jcook-200/Piano2Bluetooth/README.md

# Piano2Bluetooth
A hardware and software project to let a digital piano connect to Bluetooth headphones.

## Scructure
