jcook-200/Piano2Bluetooth/Hardware/Bluetooth2Audio_BOM.ods

Reference | Qty | Value | Footprint | Order Quantity | Datasheet
C1,C2,C3,C4,C24,C29,C30,C44,C45,C46,C49,C50,C62 | 13 | 1uF | 0603 | 20 | https://www.mouser.ca/ProductDetail/TAIYO-YUDEN/TMK107B7105KA-T?qs=PzICbMaShUfoHRKdwm1IMg%3D%3D
C5,C6,C7,C8,C9,C10,C13,C14,C18,C21,C22,C23,C25,C26,C27,C28,C36,C37,C39,C40,C41,C42,C43,C52,C54,C58 | 26 | 0.1uF | 0402 | 30 | https://www.mouser.ca/ProductDetail/Murata-Electronics/GRM155R71H104KE14D?qs=2UZY3JfgLCy9gG9icKV9Yg%3D%3D
C11,C12 | 2 | 6pF | 0402 | 10 | https://www.mouser.ca/ProductDetail/Murata-Electronics/GCM1555C1H6R0FA16D?qs=QzBtWTOodeWzC0V5O%2FcGPw%3D%3D
C15,C19 | 2 | 1uF | 0402 | 10 | https://www.mouser.ca/ProductDetail/KYOCERA-AVX/KAM05CR71A105KH?qs=mELouGlnn3cmaPoDXE8tAg%3D%3D
C16,C20 | 2 | 0.47uF | 0402 | 10 | https://www.mouser.ca/ProductDetail/TAIYO-YUDEN/LMK105B7474KV-F?qs=vF%252B8ahGVileYO6xOnPUEWw%3D%3D
C17 | 1 | 22pF | 0402 | 10 | https://www.mouser.ca/ProductDetail/Murata-Electronics/GCM1555C1H220FA16J?qs=QzBtWTOodeUtHGKP08uOlA%3D%3D
C31,C32 | 2 | 10pF | 0402 | 10 | https://www.mouser.ca/ProductDetail/Murata-Electronics/GCM1555C1H100FA16D?qs=QzBtWTOodeXF6kFfVGmBsg%3D%3D
C33,C34 | 2 | 12pF | 0402 | 10 | https://www.mouser.ca/ProductDetail/Murata-Electronics/GRT1555C1H120FA02D?qs=RcG8xmE7yp0kAtgCCwJUqg%3D%3D
Extra | 2 | 6.8pF | 0402 | 10 | https://www.mouser.ca/ProductDetail/Murata-Electronics/GCM1555C1H6R8FA16D?qs=QzBtWTOodeXhT%2FHc0qePDg%3D%3D
Extra | 2 | 8.2pF | 0402 | 10 | https://www.mouser.ca/ProductDetail/Murata-Electronics/GRM1555C1H8R2BA01D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
Extra | 2 | 15pF | 0402 | 10 | https://www.mouser.ca/ProductDetail/Murata-Electronics/GRM1555C1H150GA01D?qs=ouTquLLW2S77kt6sL0jekQ%3D%3D
Extra | 2 | 18pF | 0402 | 10 | https://www.mouser.ca/ProductDetail/Murata-Electronics/GRM1555C1H180GA01J?qs=ouTquLLW2S426X7sE1YQ3Q%3D%3D
Extra | 2 | 4.7pF | 0402 | 10 | https://www.mouser.ca/ProductDetail/Murata-Electronics/GRM1555C1H4R7BA01D?qs=ouTquLLW2S7tatpo%2F6wZ1w%3D%3D
C35,C47,C48,C57,C63 | 5 | 10uF | 0805 | 10 | https://www.mouser.ca/ProductDetail/Murata-Electronics/GRM21BZ71E106KE15L?qs=Ey7%2FXF42M3fdXe9bIpCO9w%3D%3D
C38 | 1 | 4.7uF | 0603 | 10 | https://www.mouser.ca/ProductDetail/Murata-Electronics/GRM188Z71C475KE21D?qs=d0WKAl%252BL4KajNOvalhHKtQ%3D%3D
C51,C53 | 2 | 10uF | 1206 | 10 | https://www.mouser.ca/ProductDetail/TAIYO-YUDEN/MSASG31LAB7106KTNB25?qs=tlsG%2FOw5FFiGynen7GjezA%3D%3D
C55,C59 | 2 | 1uF | 5x10mm rectangle | 3 | https://www.mouser.ca/ProductDetail/WIMA/MKS2C041001F00JSSD?qs=ISKKXg98%252B1lQgUuGZjf9mQ%3D%3D
C56,C60 | 2 | 0.01uF | 0603 | 10 | https://www.mouser.ca/ProductDetail/TAIYO-YUDEN/MSASG31LAB7106KTNB25?qs=tlsG%2FOw5FFiGynen7GjezA%3D%3D
C61 | 1 | 0.1uF | 0603 | 10 | https://www.mouser.ca/ProductDetail/YAGEO/CC0603KRX7R9BB104?qs=vTakOoo5QyLvVCYM2ge8LQ%3D%3D
FB1 | 1 | 600R | 0603 | 2 | https://www.mouser.ca/ProductDetail/TAIYO-YUDEN/LCMGA160808T601RG?qs=tlsG%2FOw5FFiusHMHvy1xRQ%3D%3D
FL1 | 1 | LFB212G45SG8C341 | 0805 | 2 | https://www.mouser.ca/ProductDetail/Murata-Electronics/LFB212G45SG8C341?qs=j1g11T5MHkp13%252BQehp0bLA%3D%3D
J1 | 1 | 01x04 Socket | 1x4 2mm | 1 | https://www.mouser.ca/ProductDetail/Samtec/HTSW-104-07-F-S?qs=0lQeLiL1qyZ97IEIrOguNw%3D%3D
J2 | 1 | Debugging STDC14 | PinHeader 02x07mm Pitch 1.27mm | 1 | https://www.mouser.ca/ProductDetail/Samtec/FTSH-107-01-F-D?qs=0lQeLiL1qyaNpP9xc4E0bg%3D%3D
J3 | 1 | 35RAPC4BV4 | 35RAPC4BV4 | 1 | https://www.mouser.ca/ProductDetail/Switchcraft/35RAPC4BV4?qs=yPI4UV3pIw2%252BAY61NTBatA%3D%3D
J4 | 1 | USB_A | USB-A Molex 67643-0901 | 1 | https://www.mouser.ca/ProductDetail/Molex/67643-0910?qs=EuyFtE1skifNhj6pwWTsXw%3D%3D
L1 | 1 | 4.7uH | 0808 | 2 | https://www.mouser.ca/ProductDetail/Coilcraft/EPL2010-472MLC?qs=zCSbvcPd3pbkiwv4%252B5Bupg%3D%3D
R1,R2,R3,R8,R9 | 5 | 10K | 0603 | 10 | https://www.mouser.ca/ProductDetail/YAGEO/AC0603FR-0710KL?qs=UoPT7wUmgYKz3zh0UDMA4Q%3D%3D
R4,R17,R20 | 3 | 100R | 0603 | 10 | https://www.mouser.ca/ProductDetail/YAGEO/RP0603BRD07100RL?qs=Y0Uzf4wQF3kknSv0x4foKw%3D%3D
R5,R6 | 2 | 4K7 | 0603 | 10 | https://www.mouser.ca/ProductDetail/YAGEO/RC0603FR-074K7L?qs=gt6vzsuosg37y0l7Vt36bQ%3D%3D
R7,R10,R11,R12,R13 | 5 | 22R | 0603 | 10 | https://www.mouser.ca/ProductDetail/YAGEO/RC0603JR-0722RL?qs=%2F9ZTgpVJnN5zDbBVzV1%252B0w%3D%3D
R14 | 1 | 150K | 0603 | 10 | https://www.mouser.ca/ProductDetail/YAGEO/AC0603FR-07150KL?qs=yhV1fb9g%2FKbGHv1fnPiGNw%3D%3D
R15 | 1 | 16K | 0603 | 10 | https://www.mouser.ca/ProductDetail/YAGEO/AC0603FR-0716KL?qs=yhV1fb9g%2FKbveWp4BLOPMQ%3D%3D
R16,R18,R19 | 3 | 0R | 0603 | 10 | https://www.mouser.ca/ProductDetail/Vishay/CRCW06030000Z0EA?qs=uFJqmf%2F3rbbVtxvMdbYUaQ%3D%3D
SW1 | 1 | EN12-VS20AF20 | EN12VS20AF20 | 1 | https://www.mouser.ca/ProductDetail/BI-Technologies-TT-Electronics/EN12-VS20AF20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
SW2 | 1 | SW | Button_Switch_SMD:SW_SPDT_PCM12 | 1 | https://www.mouser.ca/ProductDetail/CK/PCM12SMTBR?qs=By6Nw2ByBD1OEOnWcdZb2g%3D%3D
SW3 | 1 | SW_Push | Button_Switch_THT:SW_PUSH_6mm_H5mm | 1 | https://www.mouser.ca/ProductDetail/Same-Sky/TS02-66-50-BK-100-LCR-D?qs=A6eO%252BMLsxmQ2%2FFf8jET%252BrA%3D%3D
U1 | 1 | TPS7A2018PDBV | SOT-23-5 | 2 | https://www.mouser.ca/ProductDetail/Texas-Instruments/TPS7A2018PDBVR?qs=hd1VzrDQEGheW9qdrIVGew%3D%3D
U2,U8,U12 | 3 | TPS7A2033 | SOT-23-5 | 4 | https://www.mouser.ca/ProductDetail/Texas-Instruments/TPS7A2033PDBVR?qs=hd1VzrDQEGjk%2FOBnRfKB4A%3D%3D
H5 | 1 | SMS-255C | SMS-255C | 1 | https://www.mouser.ca/ProductDetail/LeaderTech/SMS-255C?qs=Em4Ro3wiPJhu73%252BqEjrpGQ%3D%3D
U4,U5,U6 | 3 | SN74AXC4T774PWR | TSSOP-16 | 3 | https://www.mouser.ca/ProductDetail/Texas-Instruments/SN74AXC4T774PWR?qs=%252B6g0mu59x7Jg9HxWxHF9JA%3D%3D
U7 | 1 | CC2564CRVMR | RVM0076A | 1 | https://www.mouser.ca/ProductDetail/Texas-Instruments/CC2564CRVMT?qs=9lcNTSmDlCqzKP5ZuYLSUg%3D%3D
U9 | 1 | STM32F446RETx | LQFP-64 | 1 | https://www.mouser.ca/ProductDetail/STMicroelectronics/STM32F446RET7?qs=qzCNEk%252BRr%252BZ3vIhuSM4Ejg%3D%3D
U10 | 1 | TPS7A2050 | SOT-23-5 | 2 | https://www.mouser.ca/ProductDetail/Texas-Instruments/TPS7A2050PDBVR?qs=hd1VzrDQEGgpoyZ%2F5FZYnQ%3D%3D
U11 | 1 | TPS61220 | SC-70-6 | 2 | https://www.mouser.ca/ProductDetail/Texas-Instruments/TPS61220DCKR?qs=IDSsxkoac0z6G7c7reIfTQ%3D%3D
U13 | 1 | PCM1808PW | TSSOP-14 | 2 | https://www.mouser.ca/ProductDetail/Texas-Instruments/PCM1808PWR?qs=iSMark9AYDUN6MG%2FdYNqIg%3D%3D
U14 | 1 | TPD2E1B06DRLR | SOT-5X3 | 2 | https://www.mouser.ca/ProductDetail/Texas-Instruments/TPD2E1B06DRLR?qs=xahoIJ7Tb4DMFivl%252BjotBg%3D%3D
U15 | 1 | USBLC6-2SC6 | SOT-23-6 | 2 | https://www.mouser.ca/ProductDetail/STMicroelectronics/USBLC6-2SC6Y?qs=gNDSiZmRJS%2FOgDexvXkdow%3D%3D
Y1 | 1 | ECS260836B2CKMTR | ECS260836B2CKMTR | 2 | https://www.mouser.ca/ProductDetail/ECS/ECS-260-8-36B2-CKM-TR?qs=QNEnbhJQKvbCAFd8XcwWtg%3D%3D
Y2 | 1 | ECS-80-10-33-CHN-TR3 | ECS801033CHNTR3 | 2 | https://www.mouser.ca/ProductDetail/ECS/ECS-80-10-33-CHN-TR?qs=W%2FMpXkg%252BdQ6xEmLXccABKw%3D%3D
Y3 | 1 | ECS327734BTR | ECS327734BTR | 2 | https://www.mouser.ca/ProductDetail/ECS/ECS-.327-7-34B-TR?qs=gmcn8Ik9O3GjcBgYgUNmLA%3D%3D
