jcook-200/Piano2Bluetooth/Hardware/Audio2BluetoothV1_Layout.pdf

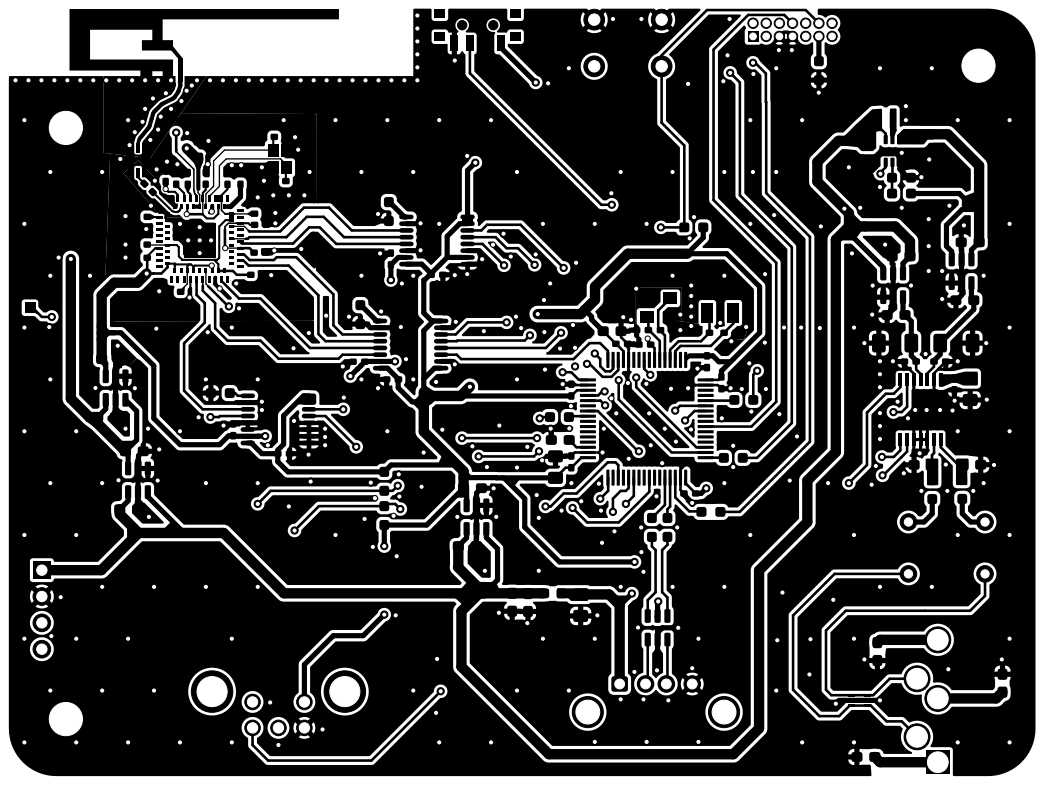
[picture p1: page 1]

Size: A4 | Rev: 1
KiCad E.D.A. 10.0.3 | Id: 1/9

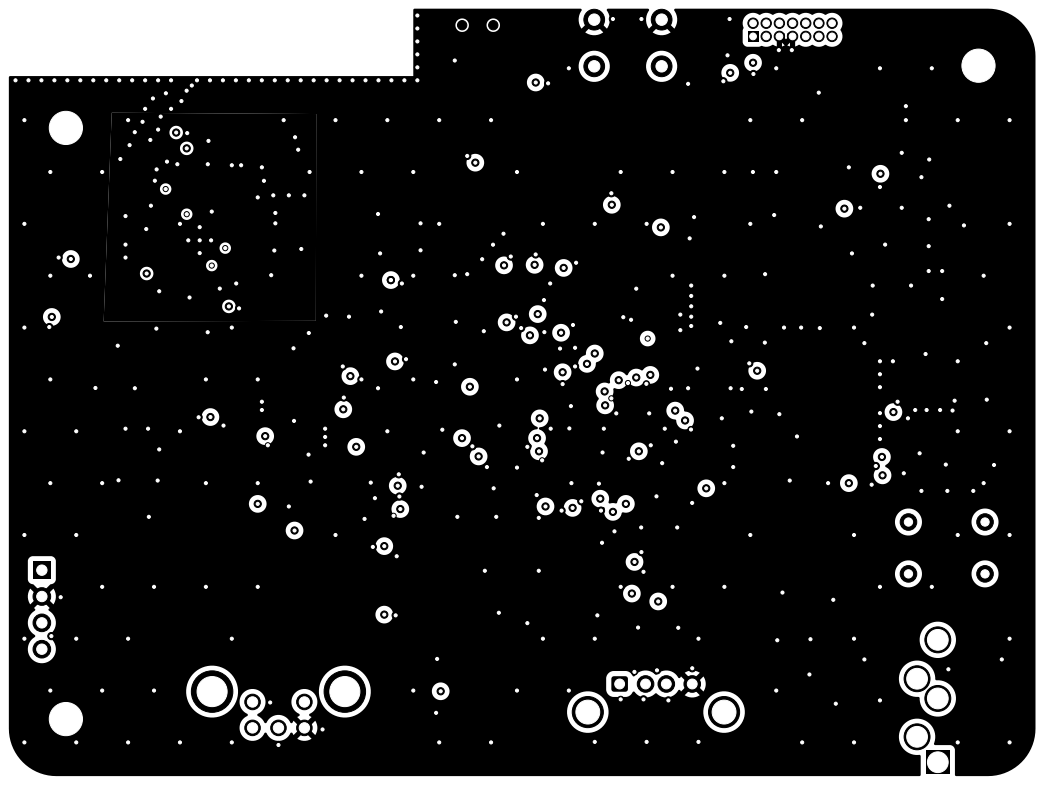
[picture p2: page 2]

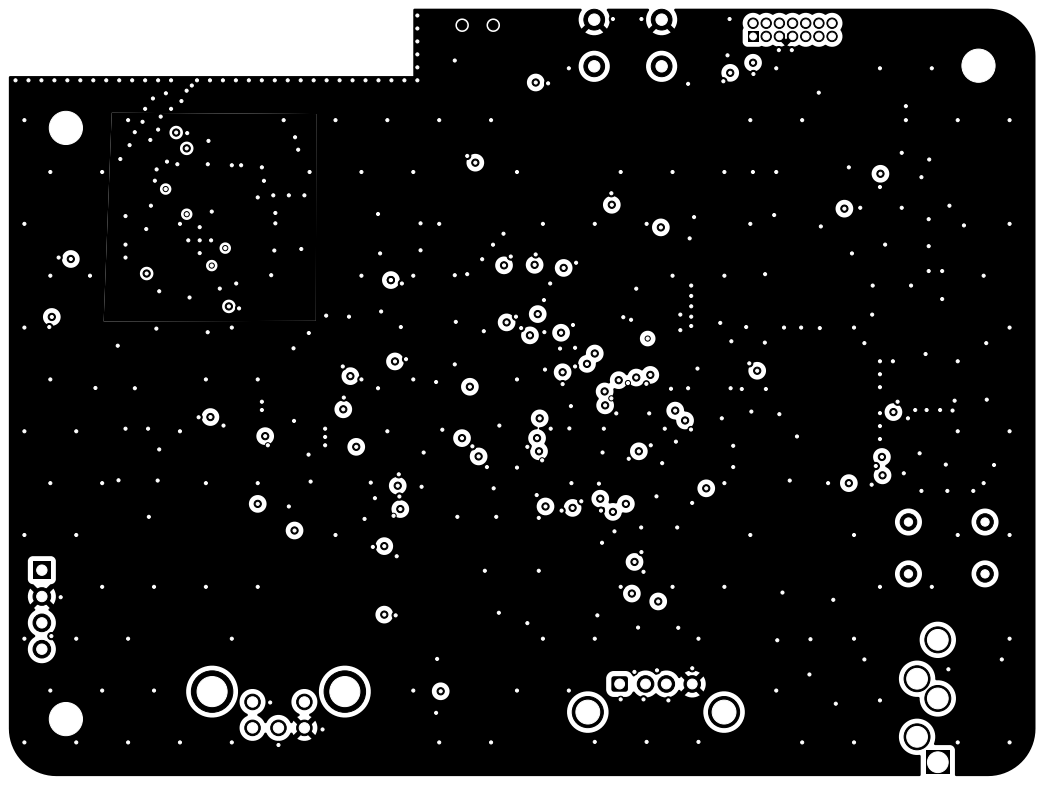
[picture p3: page 3]

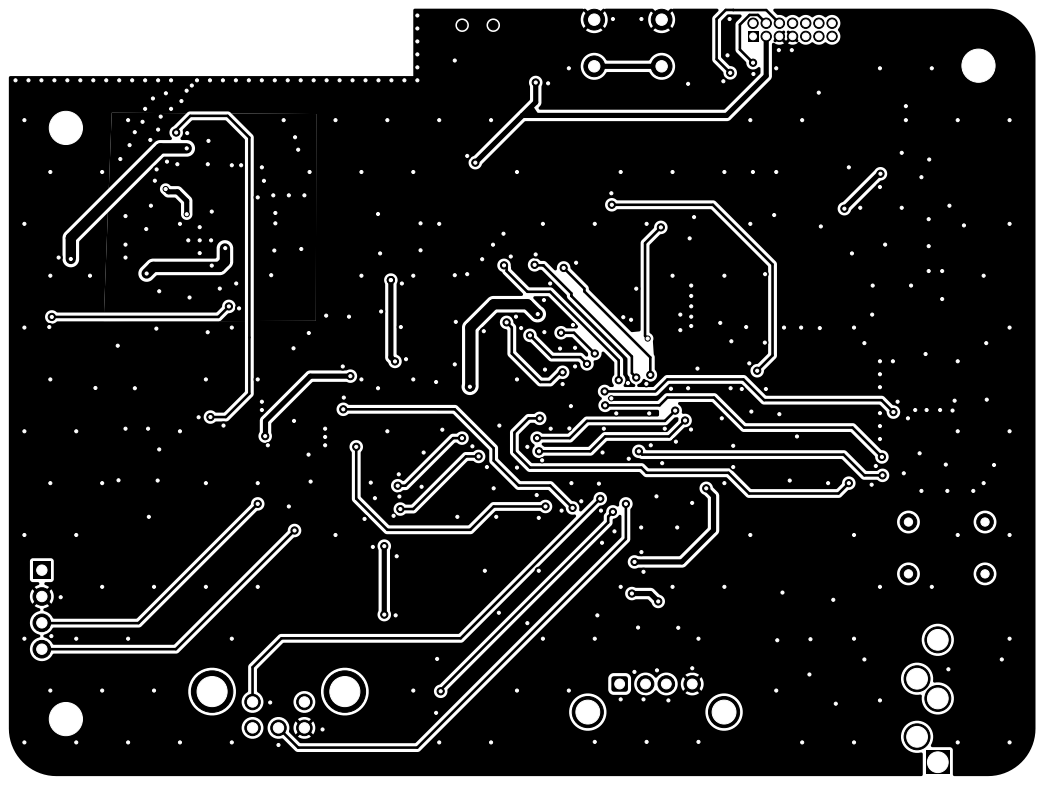
[picture p4: page 4]

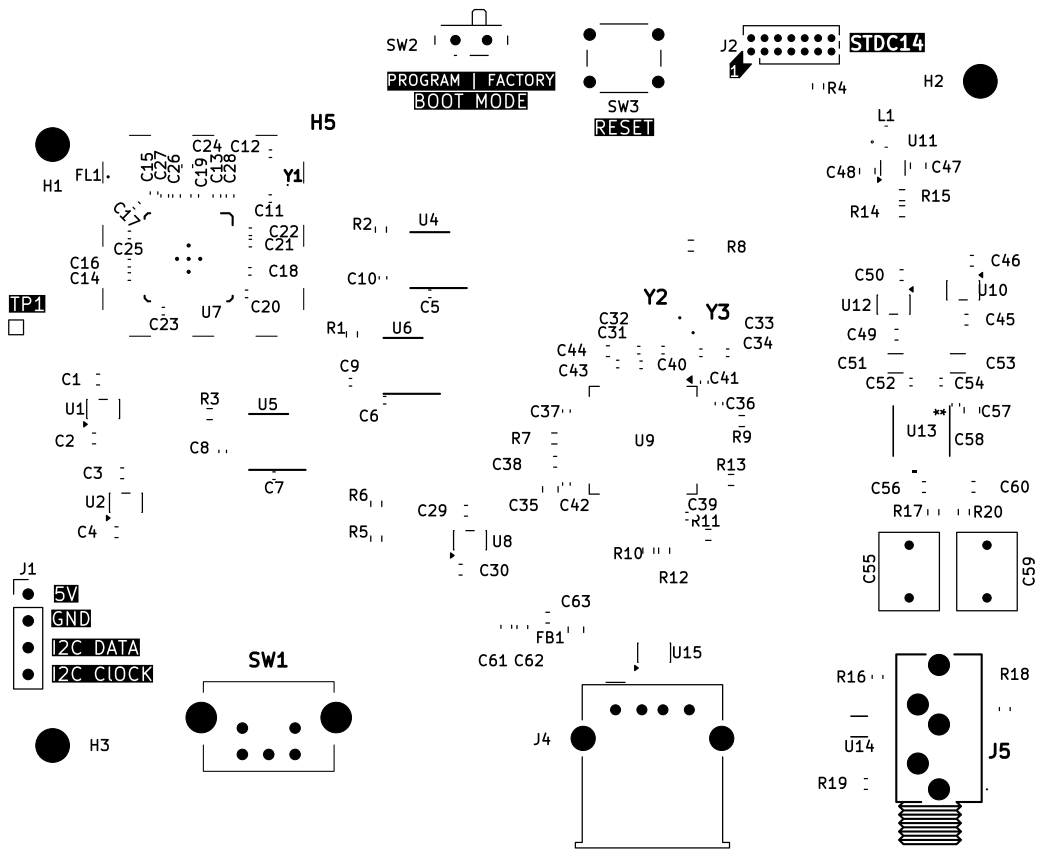
[picture p5: page 5]

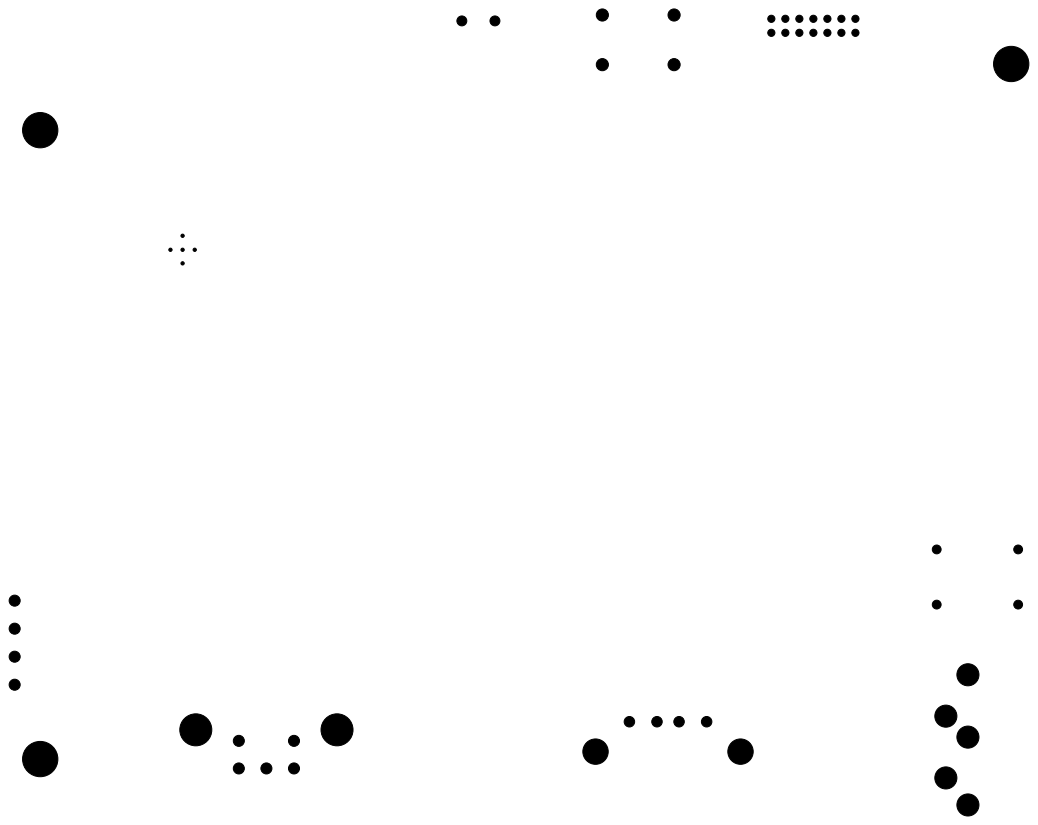
[picture p6: page 6]

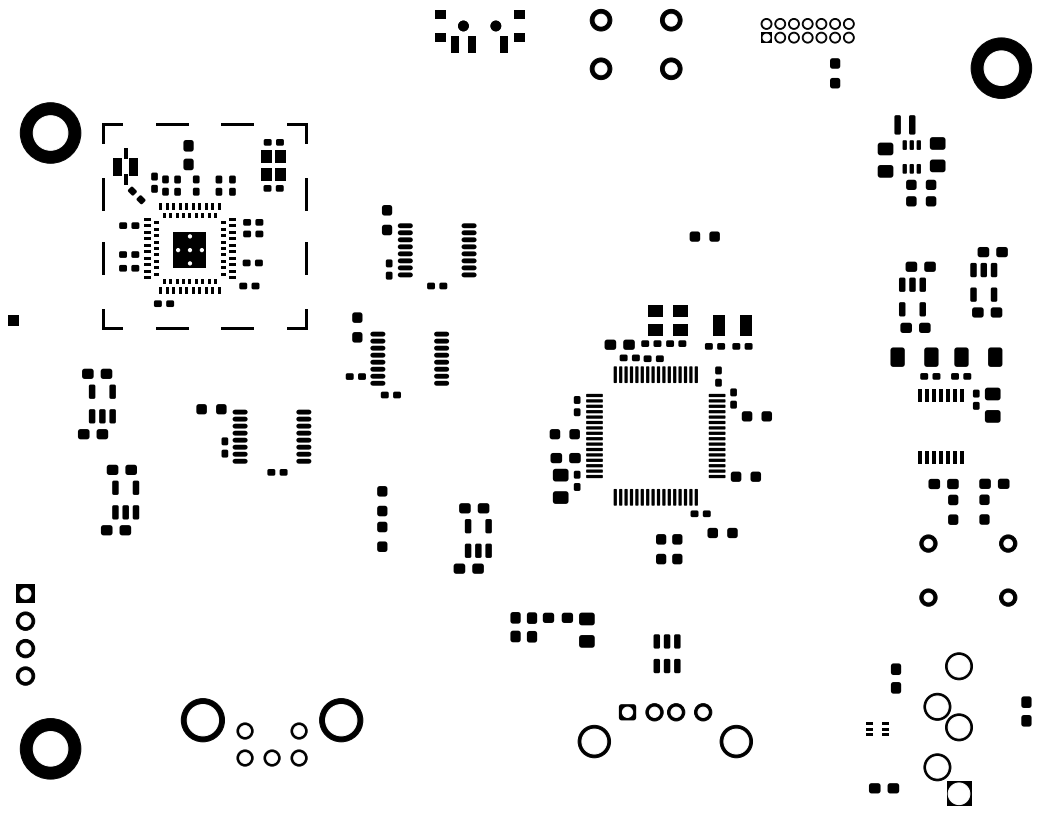
[picture p7: page 7]

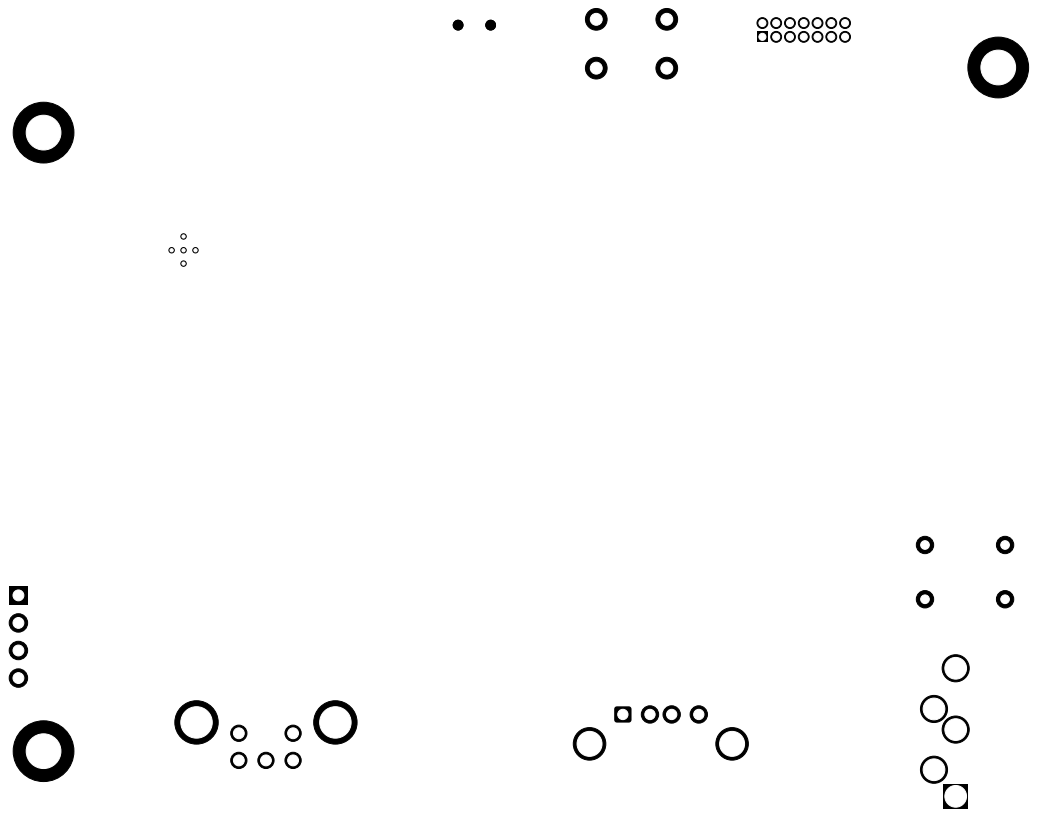
[picture p8: page 8]

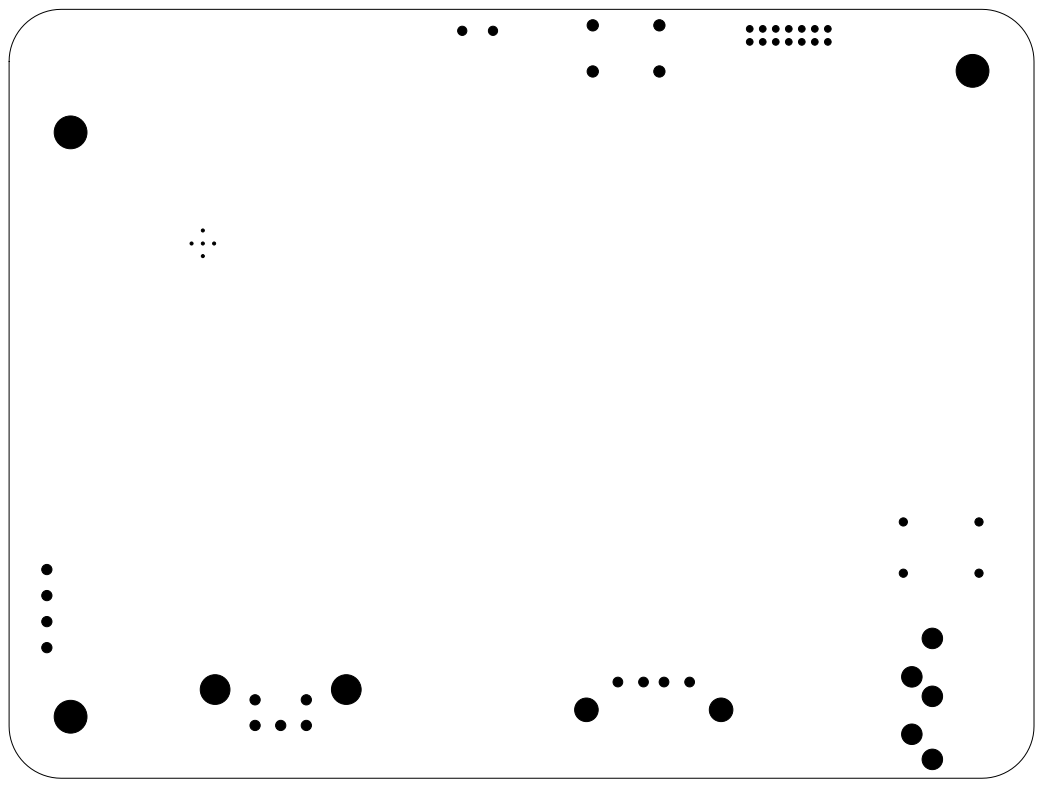
[picture p9: page 9]
