jcook-200/Piano2Bluetooth/Hardware/Audio2BluetoothV1_Schematic.pdf

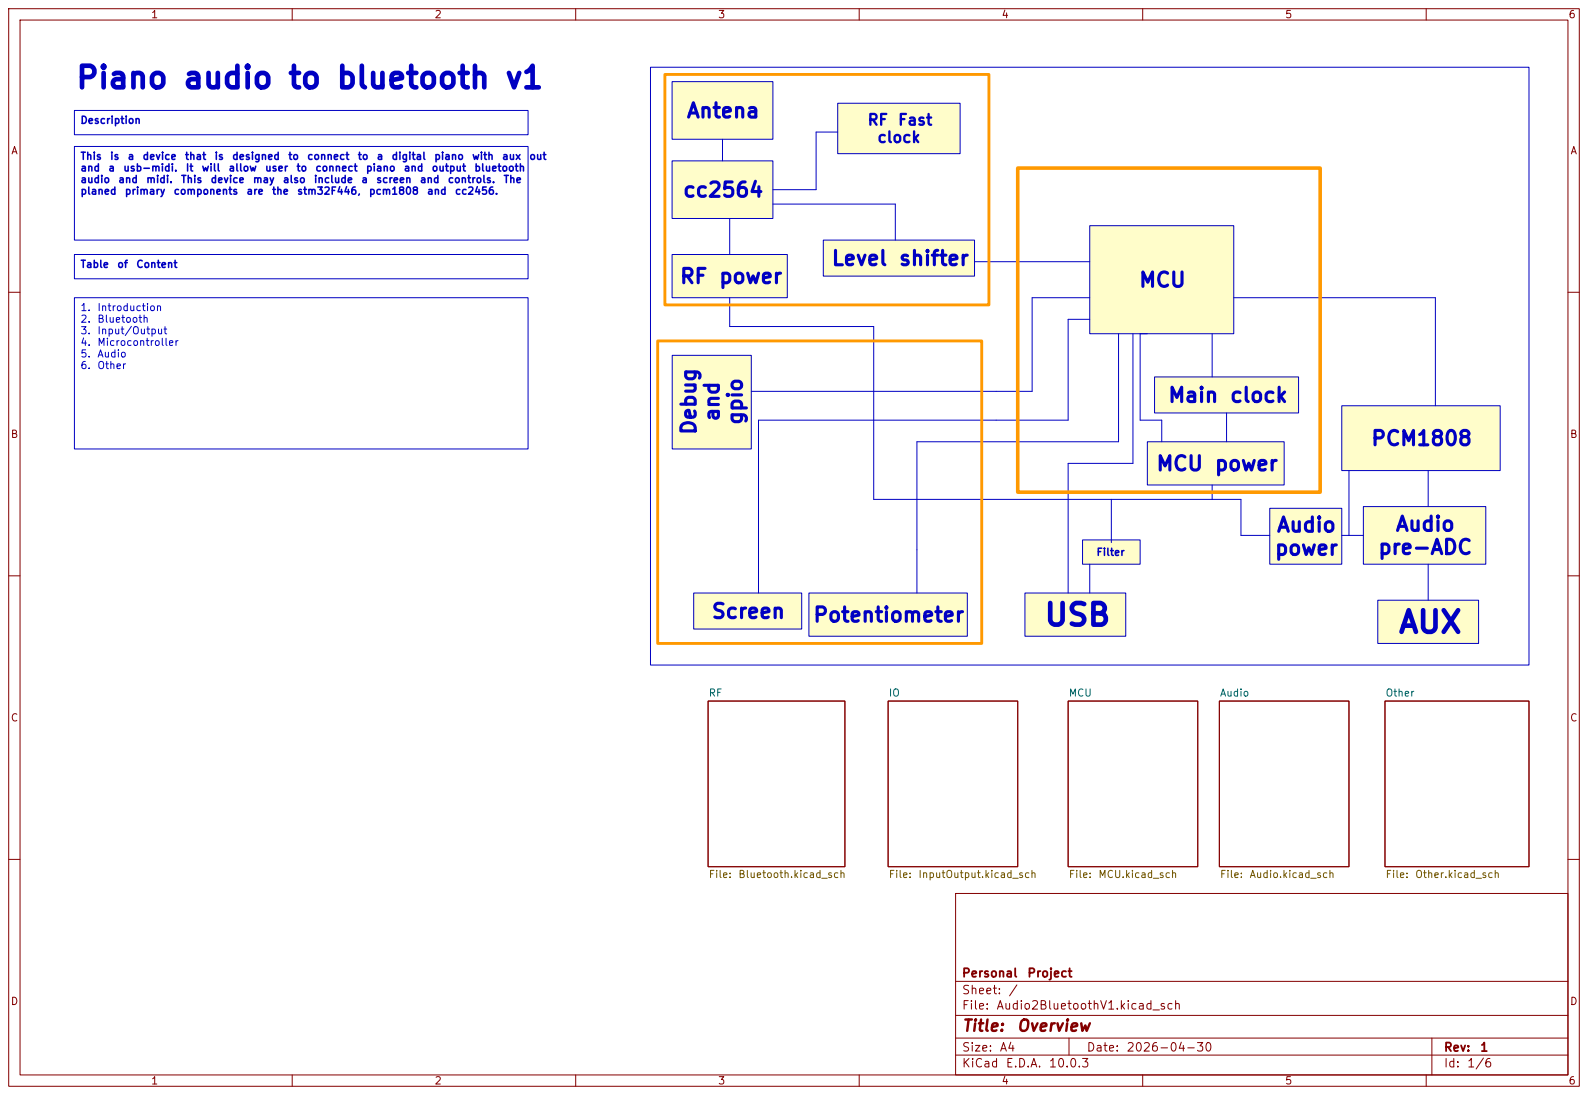
[picture p10: page 1]

Piano audio to bluetooth v1

audio and midi. This device may also include a screen and controls. The planed primary components are the stm32F446, pcm1808 and cc2456.

Size: A4 | Rev: 1
KiCad E.D.A. 10.0.3 | Id: 1/6

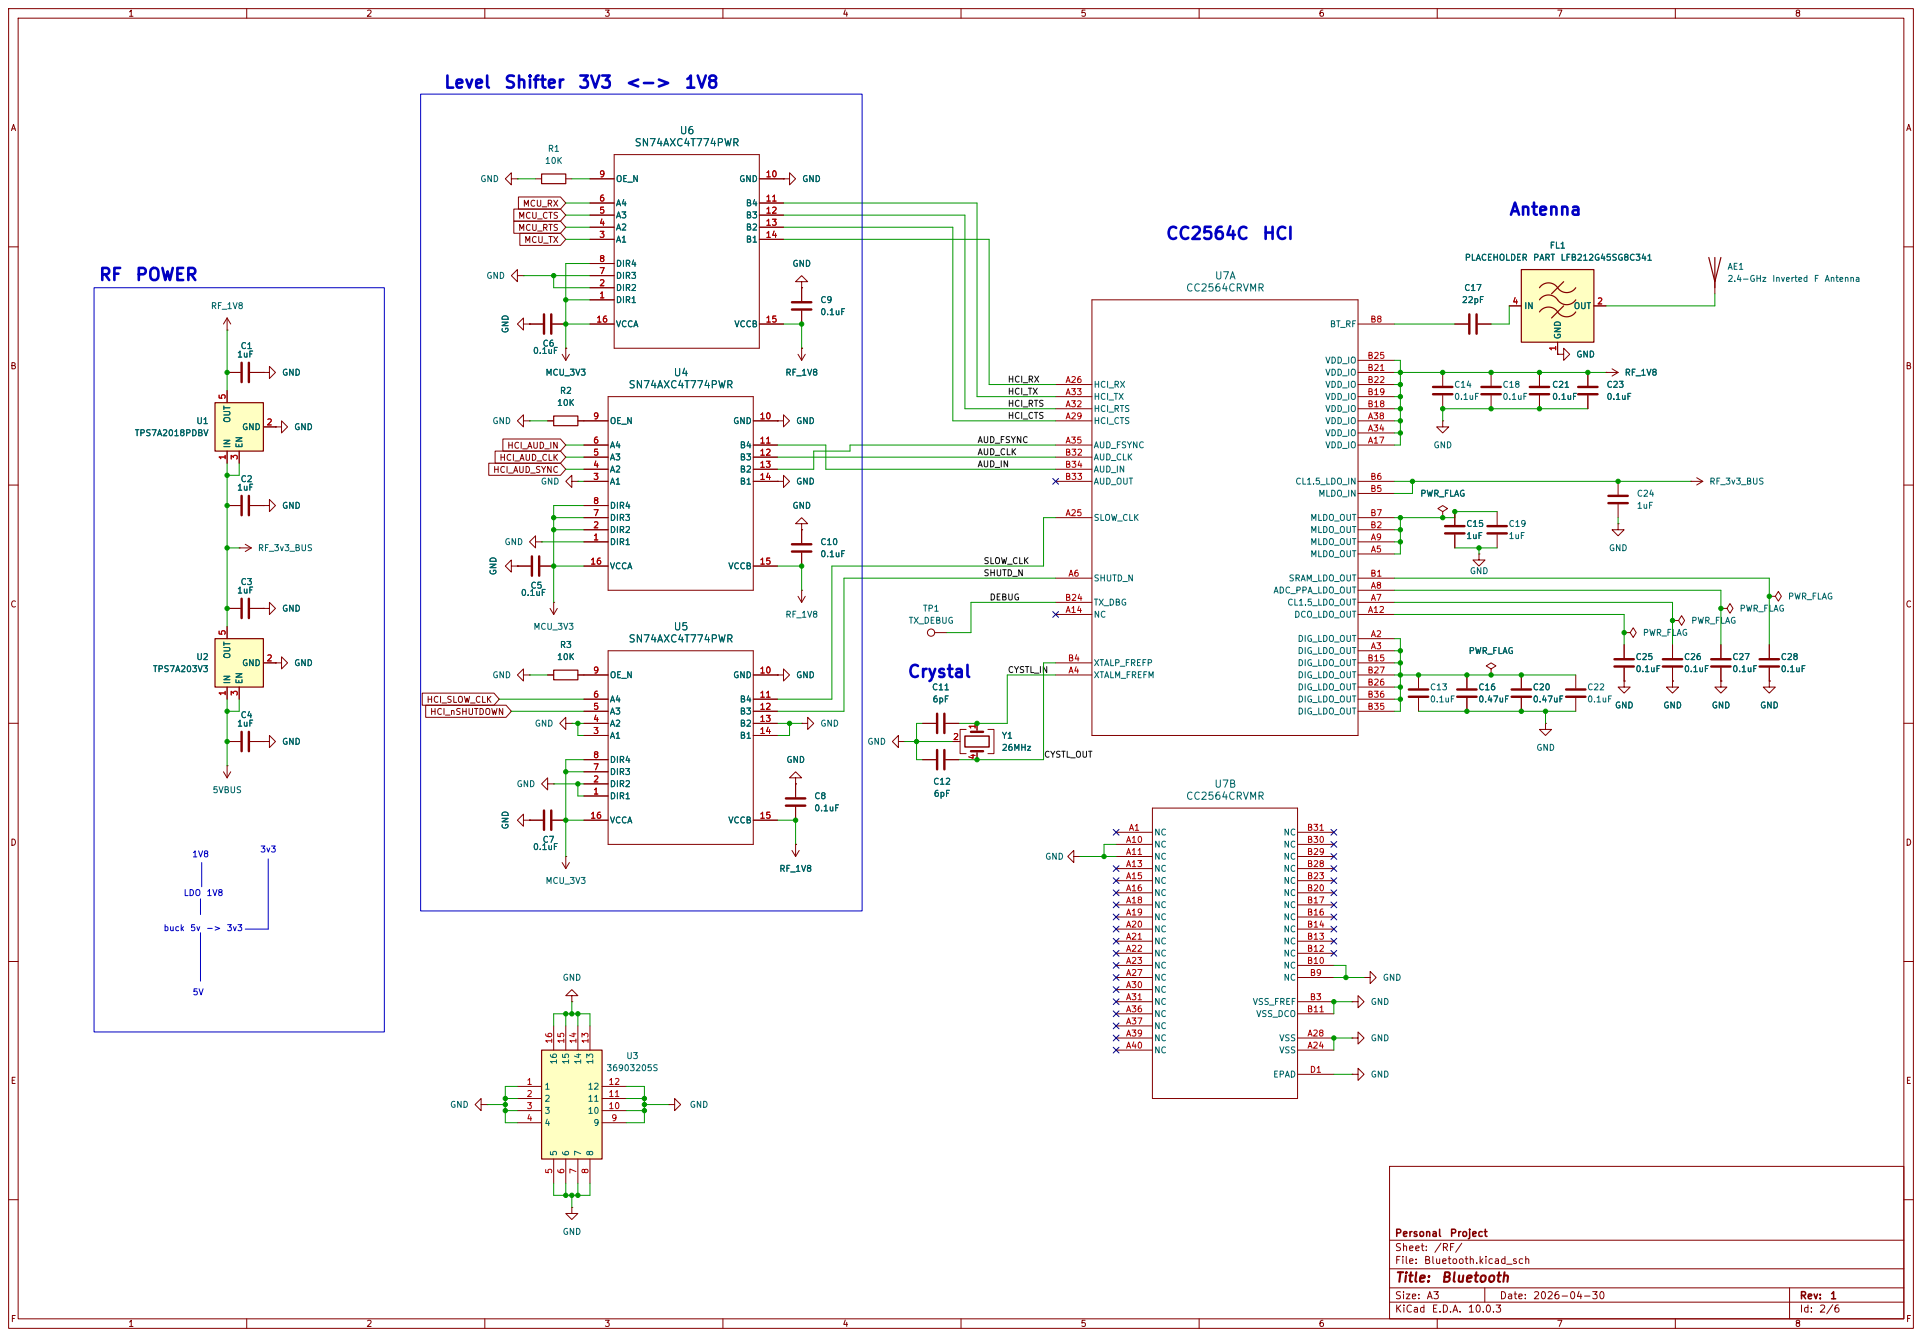
[picture p11: page 2]

A1 3 | GND GND GND | | HCI_RTS CYSTL_IN | RF_3v3_BUS IN

A2 4 | | 0.1uF GND | AUD_IN

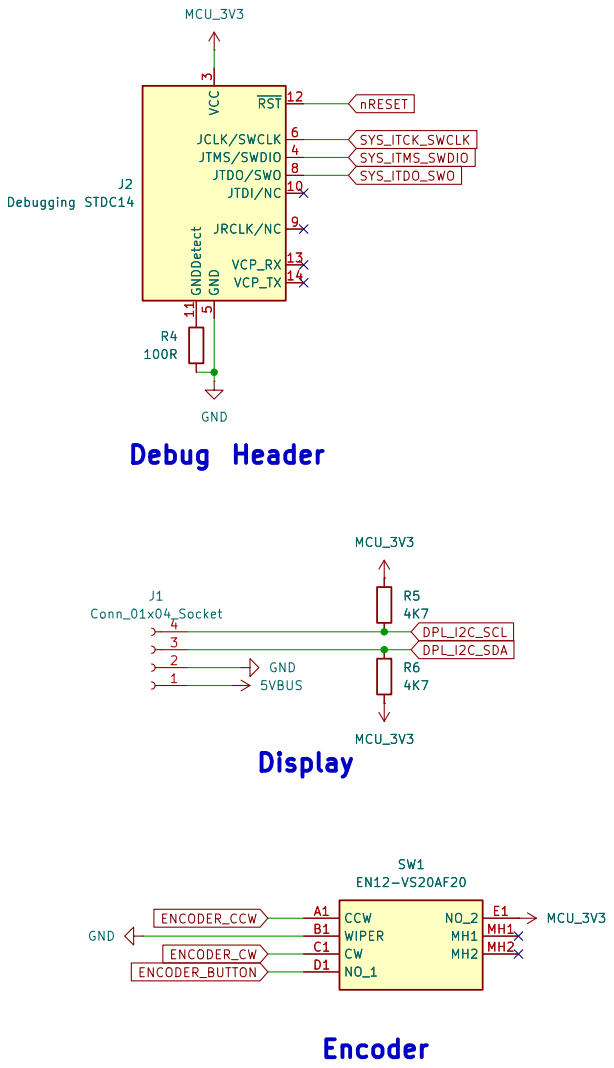
[picture p12: page 3]

Sheet: /IO/
File: InputOutput.kicad_sch
Title: Interfacing connections and components

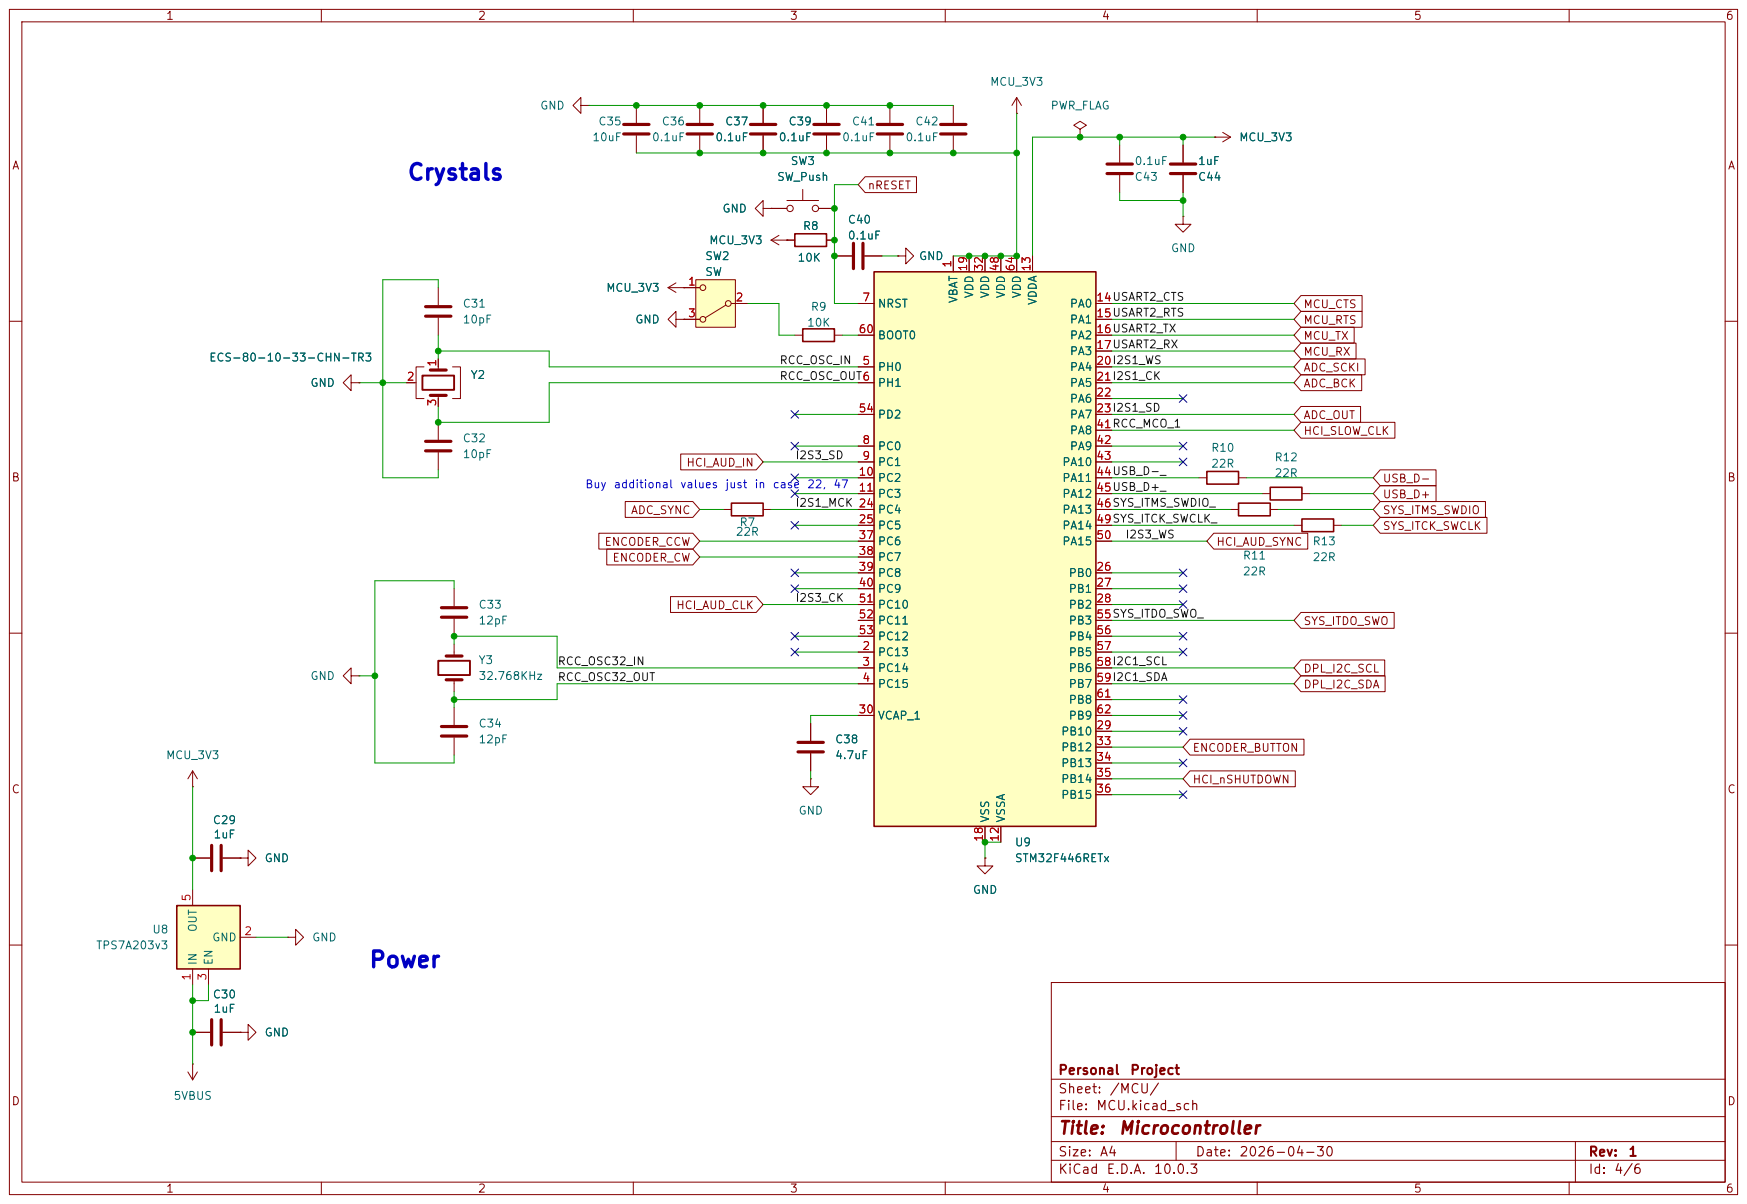
[picture p13: page 4]

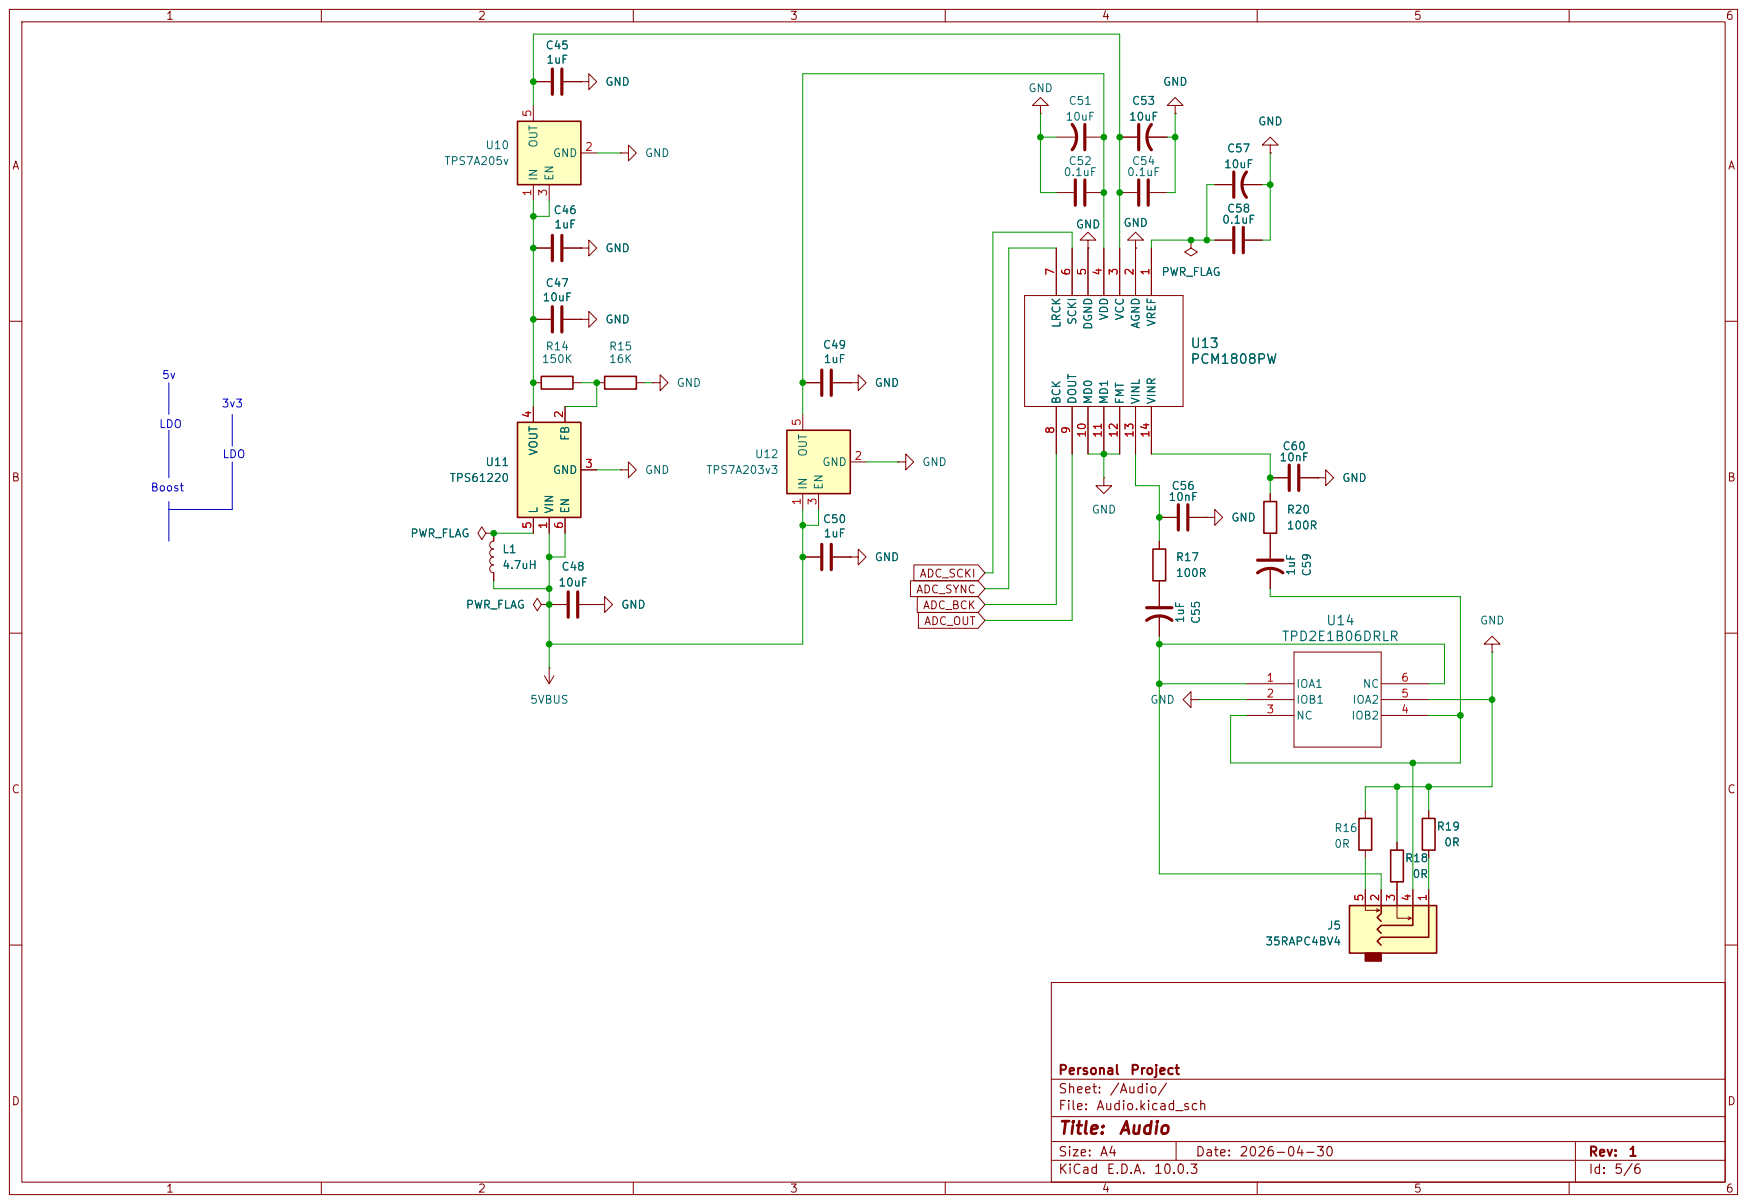
[picture p14: page 5]

8 DOUT 9 MD0 10 MD1 11 FMT 12 VINL 13 VINR 14 PWR_FLAG

8 DOUT 9 MD0 10 MD1 11 FMT 12 VINL 13 VINR 14

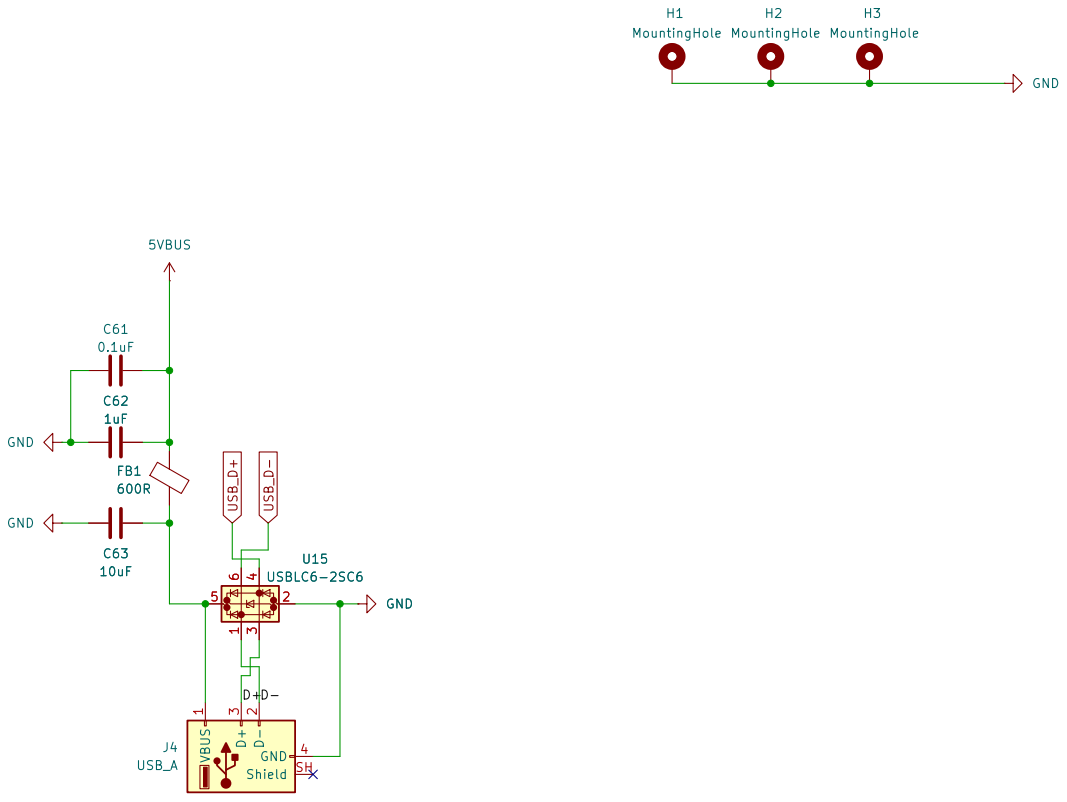
[picture p15: page 6]

Sheet: /Other/
File: Other.kicad_sch
Title: USB and mounting
