jcook-200/Piano2Bluetooth/Hardware/KiCad/Audio2BluetoothV1.kicad_pcb

## KiCad design Hardware/KiCad/Audio2BluetoothV1.kicad_pcb (2026-06-15)

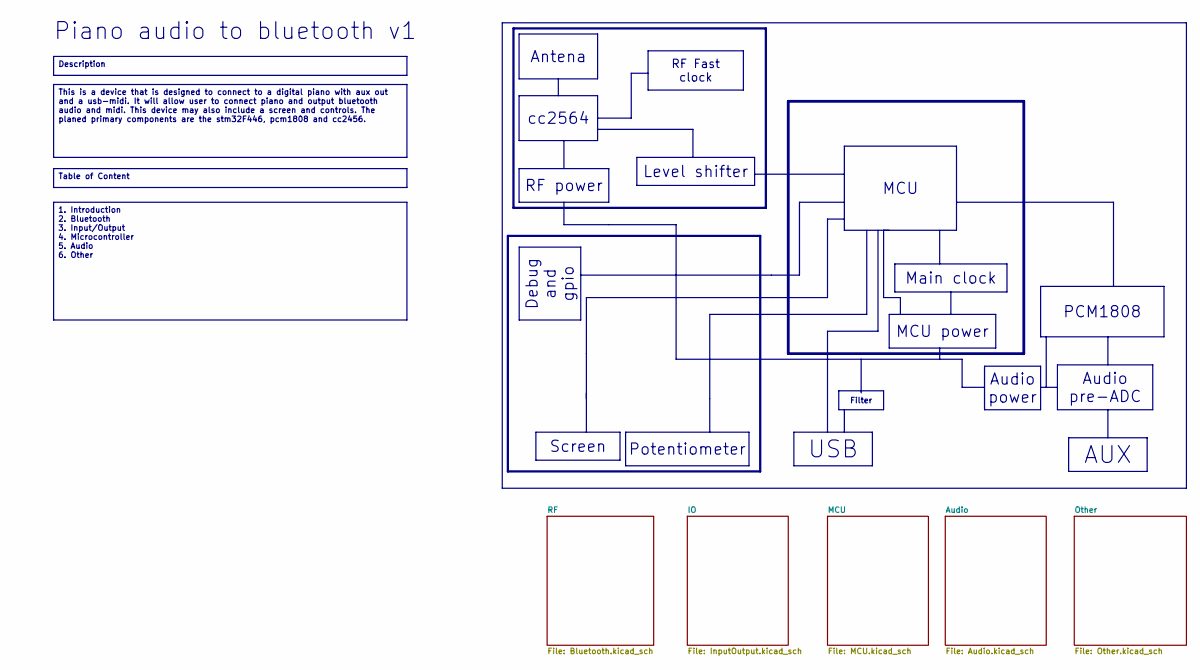
[picture p16: schematic Audio2BluetoothV1.kicad_sch, Overview]

Notes on the sheet:
Piano audio to bluetooth v1
Audio pre-ADC
Screen
Description
Debug and gpio
USB
Level shifter
RF Fast clock
Audio power
RF power
AUX
This is a device that is designed to connect to a digital piano with aux out and a usb-midi. It will allow user to connect piano and output bluetooth audio and midi. This device may also include a screen and controls. The planed primary components are the stm32F446, pcm1808 and cc2456.
1. Introduction 2. Bluetooth 3. Input/Output 4. Microcontroller 5. Audio 6. Other
Filter
MCU power
Potentiometer
MCU
Main clock
PCM1808
Table of Content
Antena
cc2564

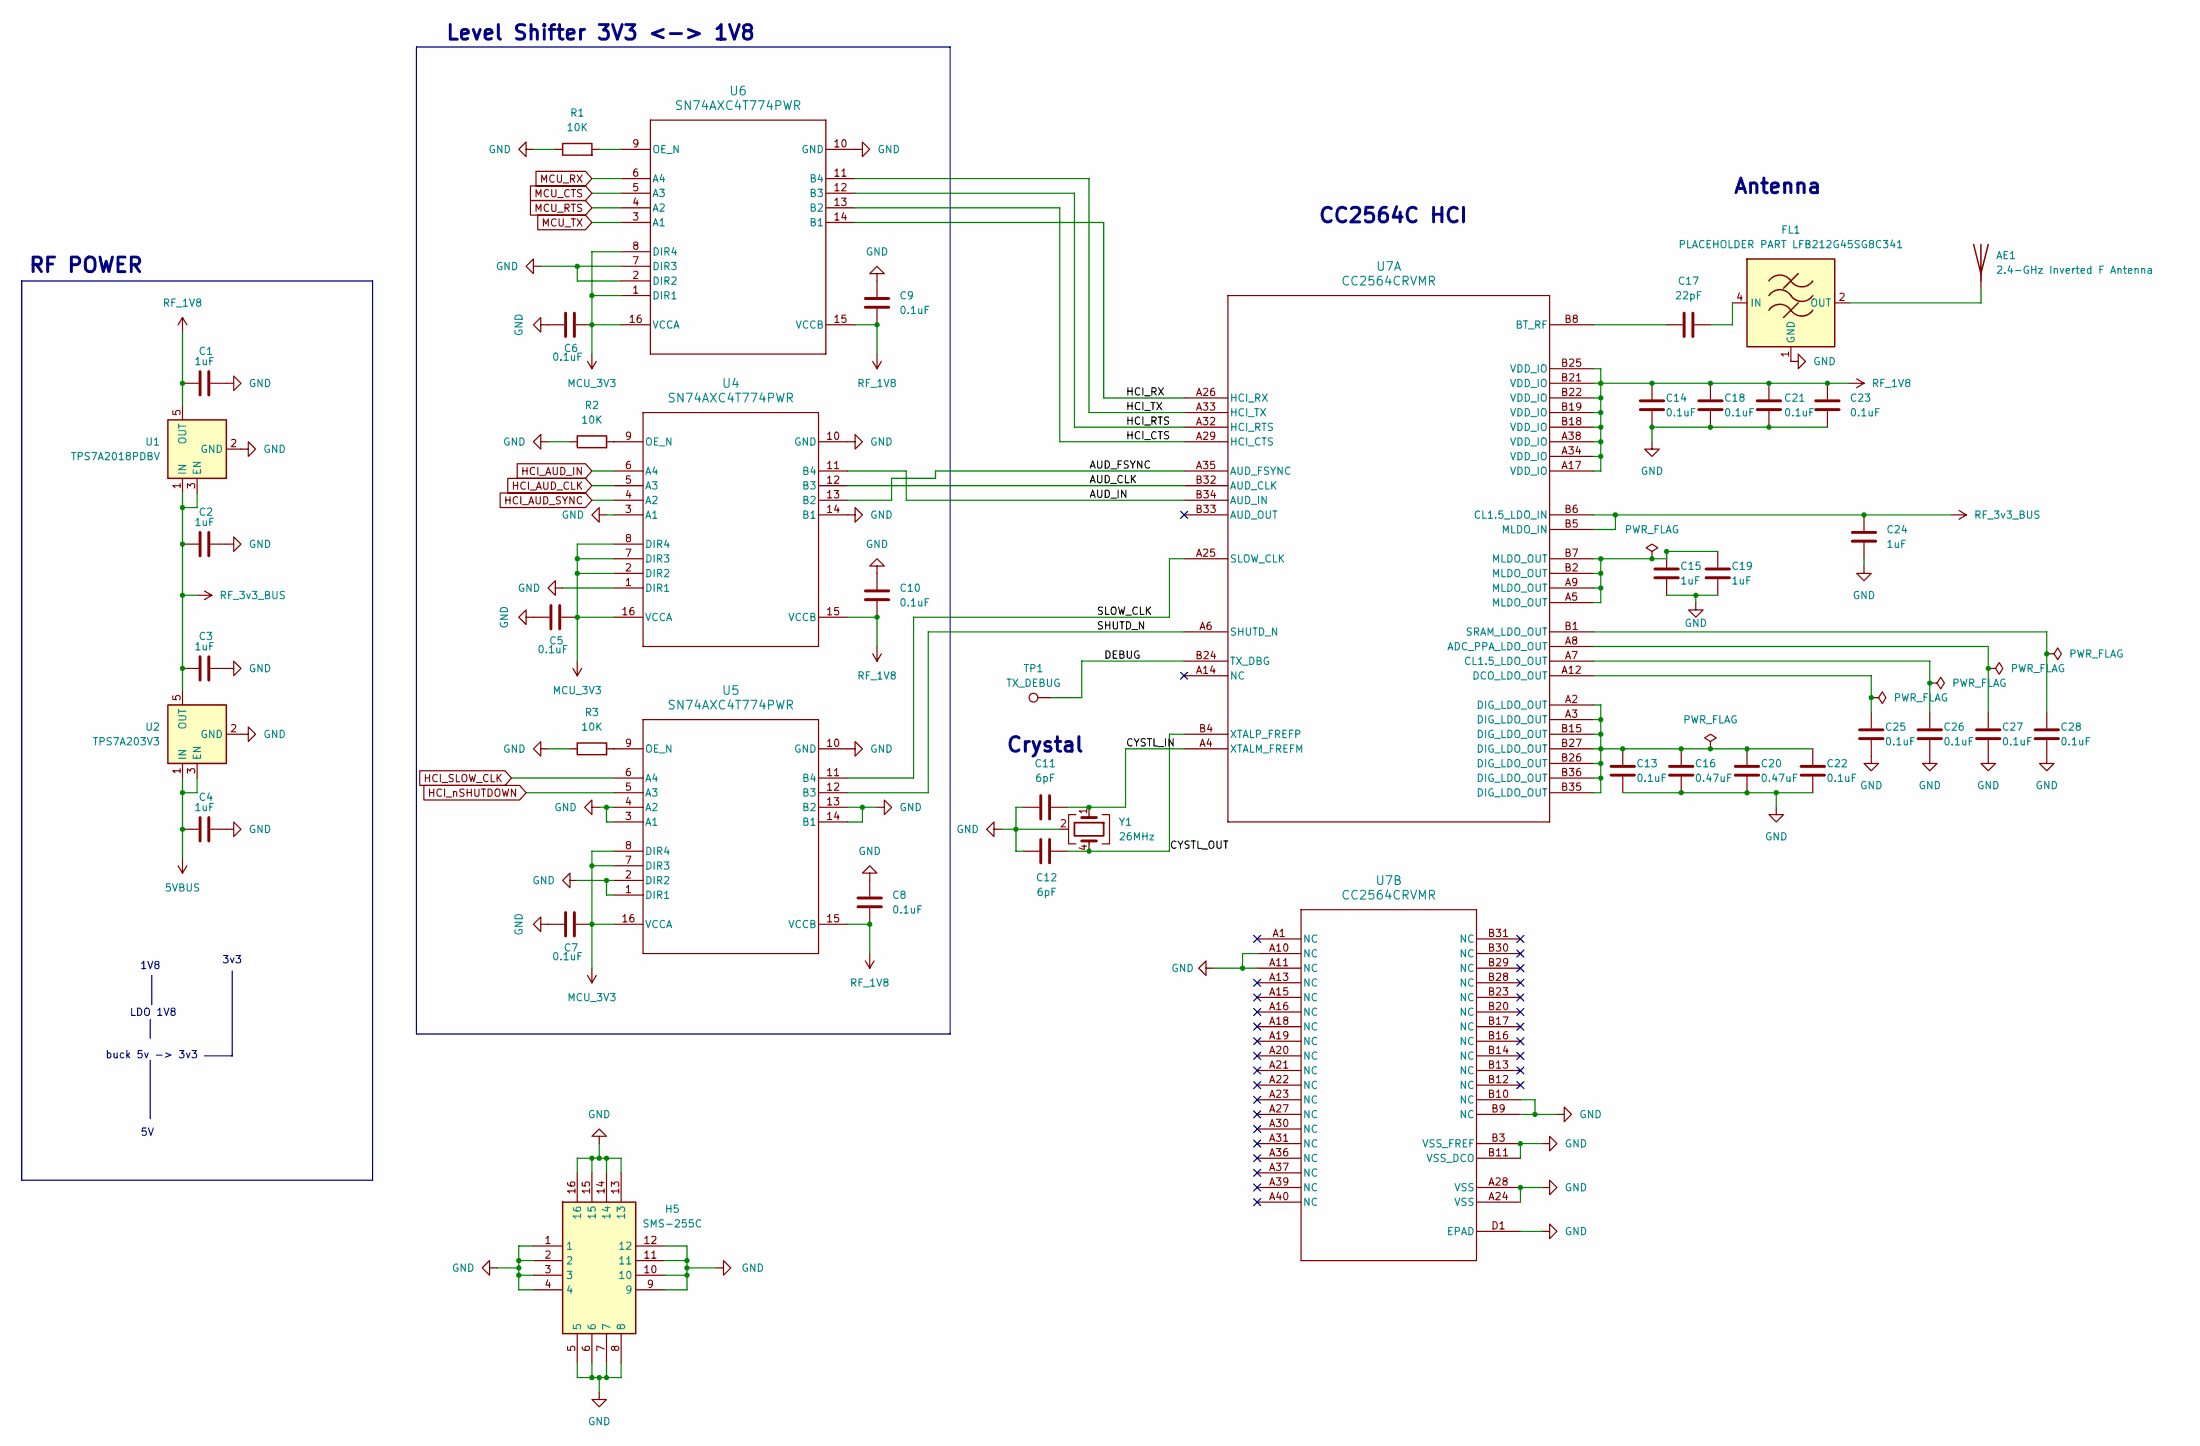
[picture p17: schematic Bluetooth.kicad_sch]

Parts:
AE1: 2.4-GHz Inverted F Antenna; Inverted F Antenna
C1, C2, C3, C4, C24: 1uF; C_0603_1608Metric_Pad1.08x0.95mm_HandSolder
C5, C6, C7, C8, C9, C10, C13, C14, C18, C21, C22, C23, C25, C26, C27, C28: 0.1uF; C_0402_1005Metric_Pad0.74x0.62mm_HandSolder
C11, C12: 6pF; C_0402_1005Metric_Pad0.74x0.62mm_HandSolder
C15, C19: 1uF; C_0402_1005Metric_Pad0.74x0.62mm_HandSolder
C16, C20: 0.47uF; C_0402_1005Metric_Pad0.74x0.62mm_HandSolder
C17: 22pF; C_0402_1005Metric_Pad0.74x0.62mm_HandSolder
FL1: PLACEHOLDER PART LFB212G45SG8C341; LFB212G45SG8C341
H5: SMS-255C; 36903205S; Mouser Part Number 710-36903205S
R1, R2, R3: 10K; R_0603_1608Metric_Pad0.98x0.95mm_HandSolder
TP1: TX_DEBUG; TestPoint_Pad_1.0x1.0mm
U1: TPS7A2018PDBV; SOT-23-5
U2: TPS7A203V3; SOT-23-5
U4, U5, U6: SN74AXC4T774PWR; PW0016A_N
U7: CC2564CRVMR; RVM0076A
Y1: 26MHz; ECS260836B2CKMTR

Connections:
5VBUS: C4.2, U2.1 (IN), U2.3 (EN); also elsewhere on the board
/RF/AUD_CLK: U4.12 (B3), U7.B32 (AUD_CLK)
/RF/AUD_FSYNC: U4.13 (B2), U7.A35 (AUD_FSYNC)
/RF/AUD_IN: U4.11 (B4), U7.B34 (AUD_IN)
/RF/CYSTL_IN: C11.2, U7.A4 (XTALM_FREFM), Y1.1
/RF/CYSTL_OUT: C12.2, U7.B4 (XTALP_FREFP), Y1.4
/RF/DEBUG: TP1.1 (1_1), U7.B24 (TX_DBG)
/RF/HCI_CTS: U6.13 (B2), U7.A29 (HCI_CTS)
/RF/HCI_RTS: U6.12 (B3), U7.A32 (HCI_RTS)
/RF/HCI_RX: U6.14 (B1), U7.A26 (HCI_RX)
/RF/HCI_TX: U6.11 (B4), U7.A33 (HCI_TX)
/RF/SHUTD_N: U5.12 (B3), U7.A6 (SHUTD_N)
/RF/SLOW_CLK: U5.11 (B4), U7.A25 (SLOW_CLK)
GND: C1.1, C2.1, C3.1, C4.1, C5.1, C6.1, C7.1, C8.1, C9.1, C10.1, C11.1, C12.1, C13.2, C14.2, C15.2, C16.2, C18.2, C19.2, C20.2, C21.2, C22.2, C23.2, C24.2, C25.2, C26.2, C27.2, C28.2, FL1.1 (GND), FL1.3 (GND), H5.1, H5.2, H5.3, H5.4, H5.5, H5.6, H5.7, H5.8, H5.9, H5.10, H5.11, H5.12, H5.13, H5.14, H5.15, H5.16, R1.1, R2.1, R3.1, U1.2 (GND), U2.2 (GND), U4.1 (DIR1), U4.3 (A1), U4.10 (GND), U4.14 (B1), U5.1 (DIR1), U5.2 (DIR2), U5.3 (A1), U5.4 (A2), U5.10 (GND), U5.13 (B2), U5.14 (B1), U6.2 (DIR2), U6.7 (DIR3), U6.10 (GND), U7.A10 (NC), U7.A11 (NC), U7.A24 (VSS), U7.A28 (VSS), U7.B3 (VSS_FREF), U7.B9 (NC), U7.B10 (NC), U7.B11 (VSS_DCO), U7.D1 (EPAD), Y1.2 (G), Y1.3 (G); also elsewhere on the board
HCI_AUD_CLK: U4.5 (A3); also elsewhere on the board
HCI_AUD_IN: U4.6 (A4); also elsewhere on the board
HCI_AUD_SYNC: U4.4 (A2); also elsewhere on the board
HCI_SLOW_CLK: U5.6 (A4); also elsewhere on the board
HCI_nSHUTDOWN: U5.5 (A3); also elsewhere on the board
MCU_3V3: C5.2, C6.2, C7.2, U4.2 (DIR2), U4.7 (DIR3), U4.8 (DIR4), U4.16 (VCCA), U5.7 (DIR3), U5.8 (DIR4), U5.16 (VCCA), U6.1 (DIR1), U6.8 (DIR4), U6.16 (VCCA); also elsewhere on the board
MCU_CTS: U6.5 (A3); also elsewhere on the board
MCU_RTS: U6.4 (A2); also elsewhere on the board
MCU_RX: U6.6 (A4); also elsewhere on the board
MCU_TX: U6.3 (A1); also elsewhere on the board
unnamed: AE1.1, FL1.2 (OUT)
unnamed: C13.1, C16.1, C20.1, C22.1, U7.A2 (DIG_LDO_OUT), U7.A3 (DIG_LDO_OUT), U7.B15 (DIG_LDO_OUT), U7.B26 (DIG_LDO_OUT), U7.B27 (DIG_LDO_OUT), U7.B35 (DIG_LDO_OUT), U7.B36 (DIG_LDO_OUT)
unnamed: C15.1, C19.1, U7.A5 (MLDO_OUT), U7.A9 (MLDO_OUT), U7.B2 (MLDO_OUT), U7.B7 (MLDO_OUT)
unnamed: C17.2, FL1.4 (IN)
unnamed: R2.2, U4.9 (OE_N)
unnamed: R3.2, U5.9 (OE_N)
unnamed: R1.2, U6.9 (OE_N)
unnamed: C27.1, U7.A8 (ADC_PPA_LDO_OUT)
unnamed: C17.1, U7.B8 (BT_RF)
unnamed: C26.1, U7.A7 (CL1.5_LDO_OUT)
unnamed: C25.1, U7.A12 (DCO_LDO_OUT)
unnamed: C28.1, U7.B1 (SRAM_LDO_OUT)
RF_1V8: C1.2, C8.2, C9.2, C10.2, C14.1, C18.1, C21.1, C23.1, U1.5 (OUT), U4.15 (VCCB), U5.15 (VCCB), U6.15 (VCCB), U7.A17 (VDD_IO), U7.A34 (VDD_IO), U7.A38 (VDD_IO), U7.B18 (VDD_IO), U7.B19 (VDD_IO), U7.B21 (VDD_IO), U7.B22 (VDD_IO), U7.B25 (VDD_IO)
RF_3v3_BUS: C2.2, C3.2, C24.1, U1.1 (IN), U1.3 (EN), U2.5 (OUT), U7.B5 (MLDO_IN), U7.B6 (CL1.5_LDO_IN)

Notes on the sheet:
LDO 1V8
Antenna
CC2564C HCI
Level Shifter 3V3 <-> 1V8
Crystal
1V8
RF POWER
3v3
buck 5v -> 3v3

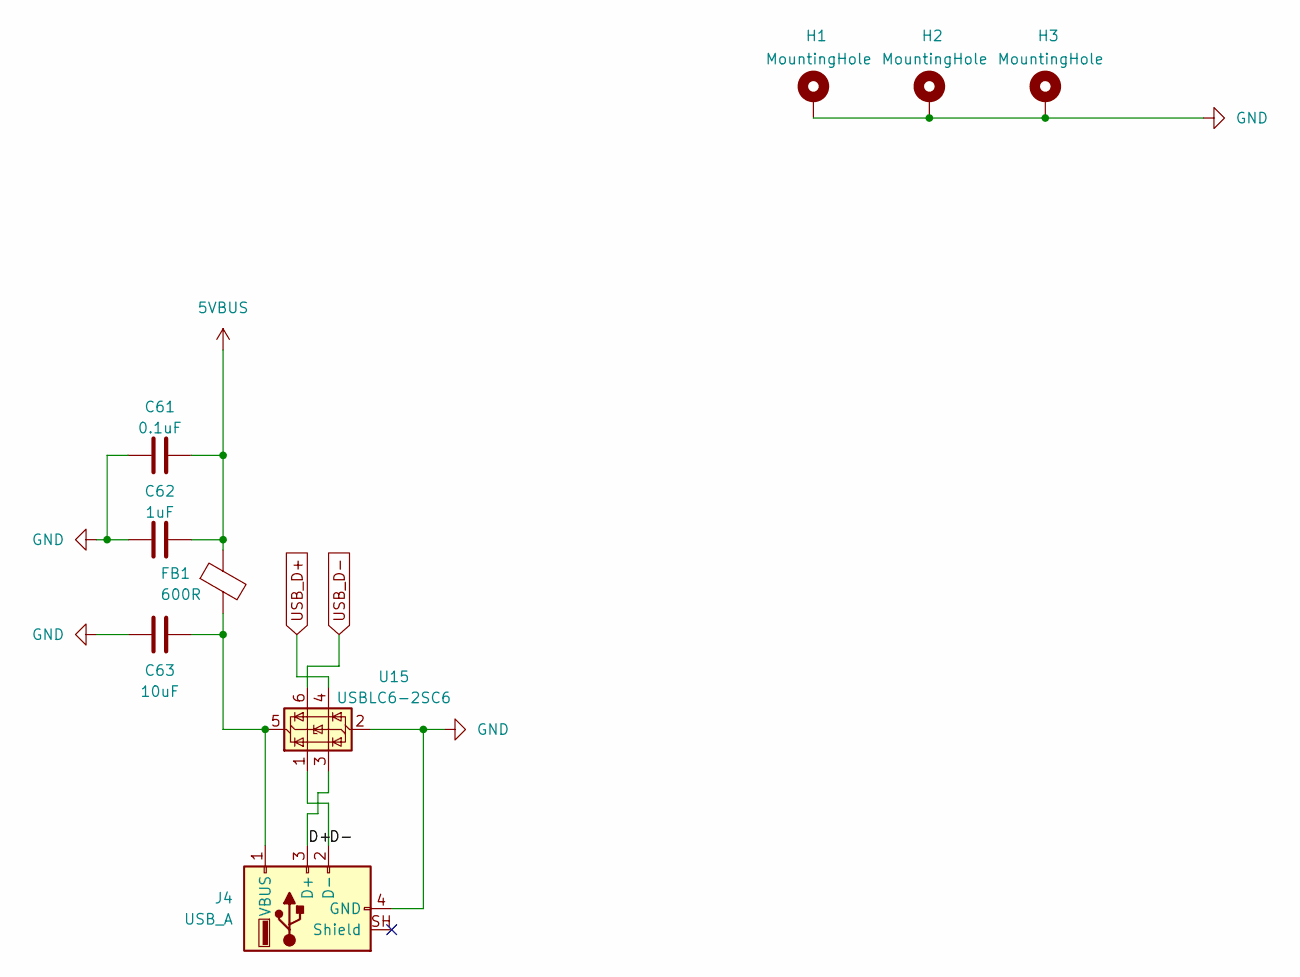
[picture p18: schematic Other.kicad_sch, USB and mounting]

Parts:
C61: 0.1uF; C_0603_1608Metric_Pad1.08x0.95mm_HandSolder
C62: 1uF; C_0603_1608Metric_Pad1.08x0.95mm_HandSolder
C63: 10uF; C_0805_2012Metric_Pad1.18x1.45mm_HandSolder
FB1: 600R; L_0603_1608Metric_Pad1.05x0.95mm_HandSolder
H1, H2, H3: MountingHole; MountingHole_3.2mm_M3_DIN965_Pad
J4: USB_A; USB_A_Molex_67643_Horizontal
U15: USBLC6-2SC6; SOT-23-6

Connections:
5VBUS: C61.2, C62.2, FB1.1; also elsewhere on the board
/Other/D+: J4.3 (D+), U15.3 (I/O2)
/Other/D-: J4.2 (D-), U15.1 (I/O1)
GND: C61.1, C62.1, C63.1, H1.1 (1_1), H2.1 (1_1), H3.1 (1_1), J4.4 (GND), U15.2 (GND); also elsewhere on the board
unnamed: C63.2, FB1.2, J4.1 (VBUS), U15.5 (VBUS)
USB_D+: U15.4 (I/O2); also elsewhere on the board
USB_D-: U15.6 (I/O1); also elsewhere on the board

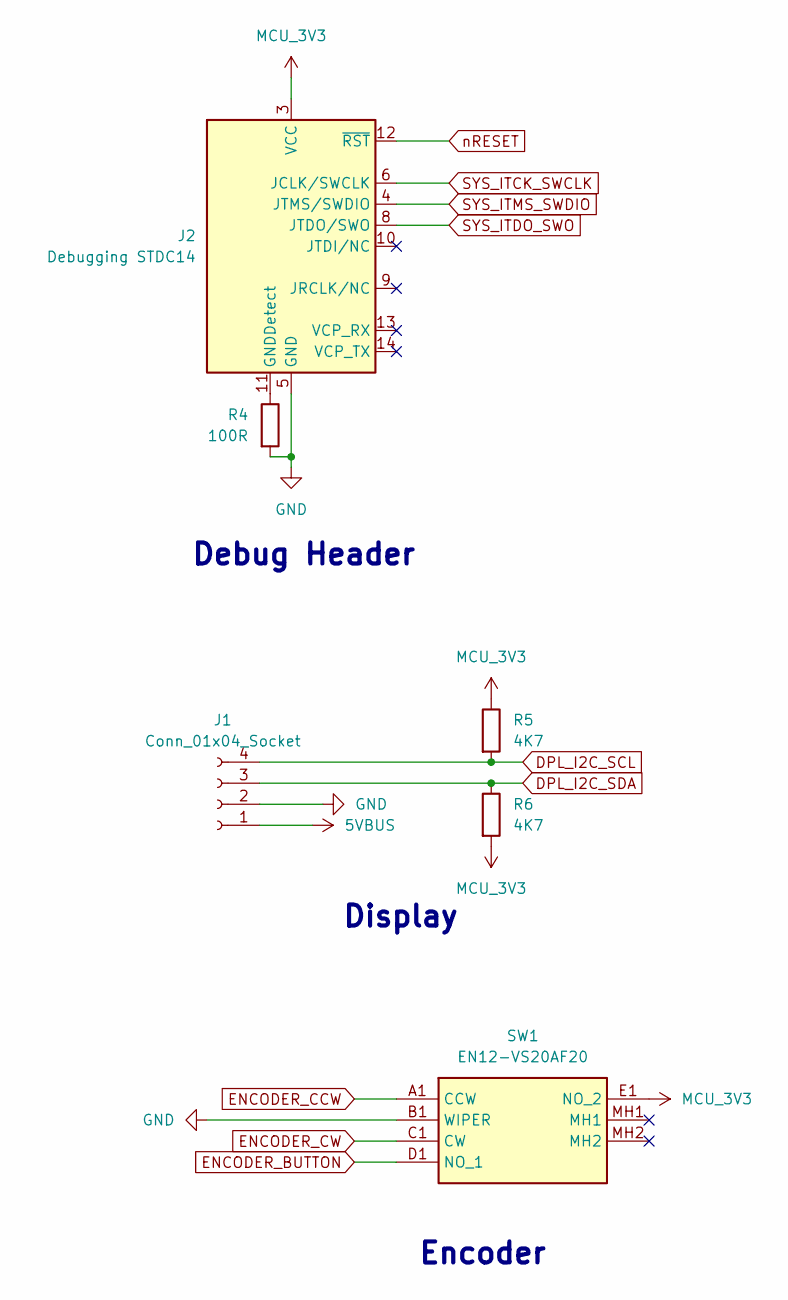
[picture p19: schematic InputOutput.kicad_sch, Interfacing connections and components]

Parts:
J1: Conn_01x04_Socket; PinHeader_1x04_P2.54mm_Vertical
J2: Debugging STDC14; PinHeader_2x07_P1.27mm_Vertical
R4: 100R; R_0603_1608Metric_Pad0.98x0.95mm_HandSolder
R5, R6: 4K7; R_0603_1608Metric_Pad0.98x0.95mm_HandSolder
SW1: EN12-VS20AF20; EN12VS20AF20; Mouser Part Number 858-EN12VS20AF20

Connections:
5VBUS: J1.1; also elsewhere on the board
DPL_I2C_SCL: J1.4, R5.2; also elsewhere on the board
DPL_I2C_SDA: J1.3, R6.1; also elsewhere on the board
ENCODER_BUTTON: SW1.D1 (NO_1); also elsewhere on the board
ENCODER_CCW: SW1.A1 (CCW); also elsewhere on the board
ENCODER_CW: SW1.C1 (CW); also elsewhere on the board
GND: J1.2, J2.5 (GND), J2.7 (GND), R4.2, SW1.B1 (WIPER); also elsewhere on the board
MCU_3V3: J2.3 (VCC), R5.1, R6.2, SW1.E1 (NO_2); also elsewhere on the board
unnamed: J2.11 (GNDDetect), R4.1
SYS_ITCK_SWCLK: J2.6 (JCLK/SWCLK); also elsewhere on the board
SYS_ITDO_SWO: J2.8 (JTDO/SWO); also elsewhere on the board
SYS_ITMS_SWDIO: J2.4 (JTMS/SWDIO); also elsewhere on the board
nRESET: J2.12 (~RST); also elsewhere on the board

Notes on the sheet:
Debug Header
Encoder
Display

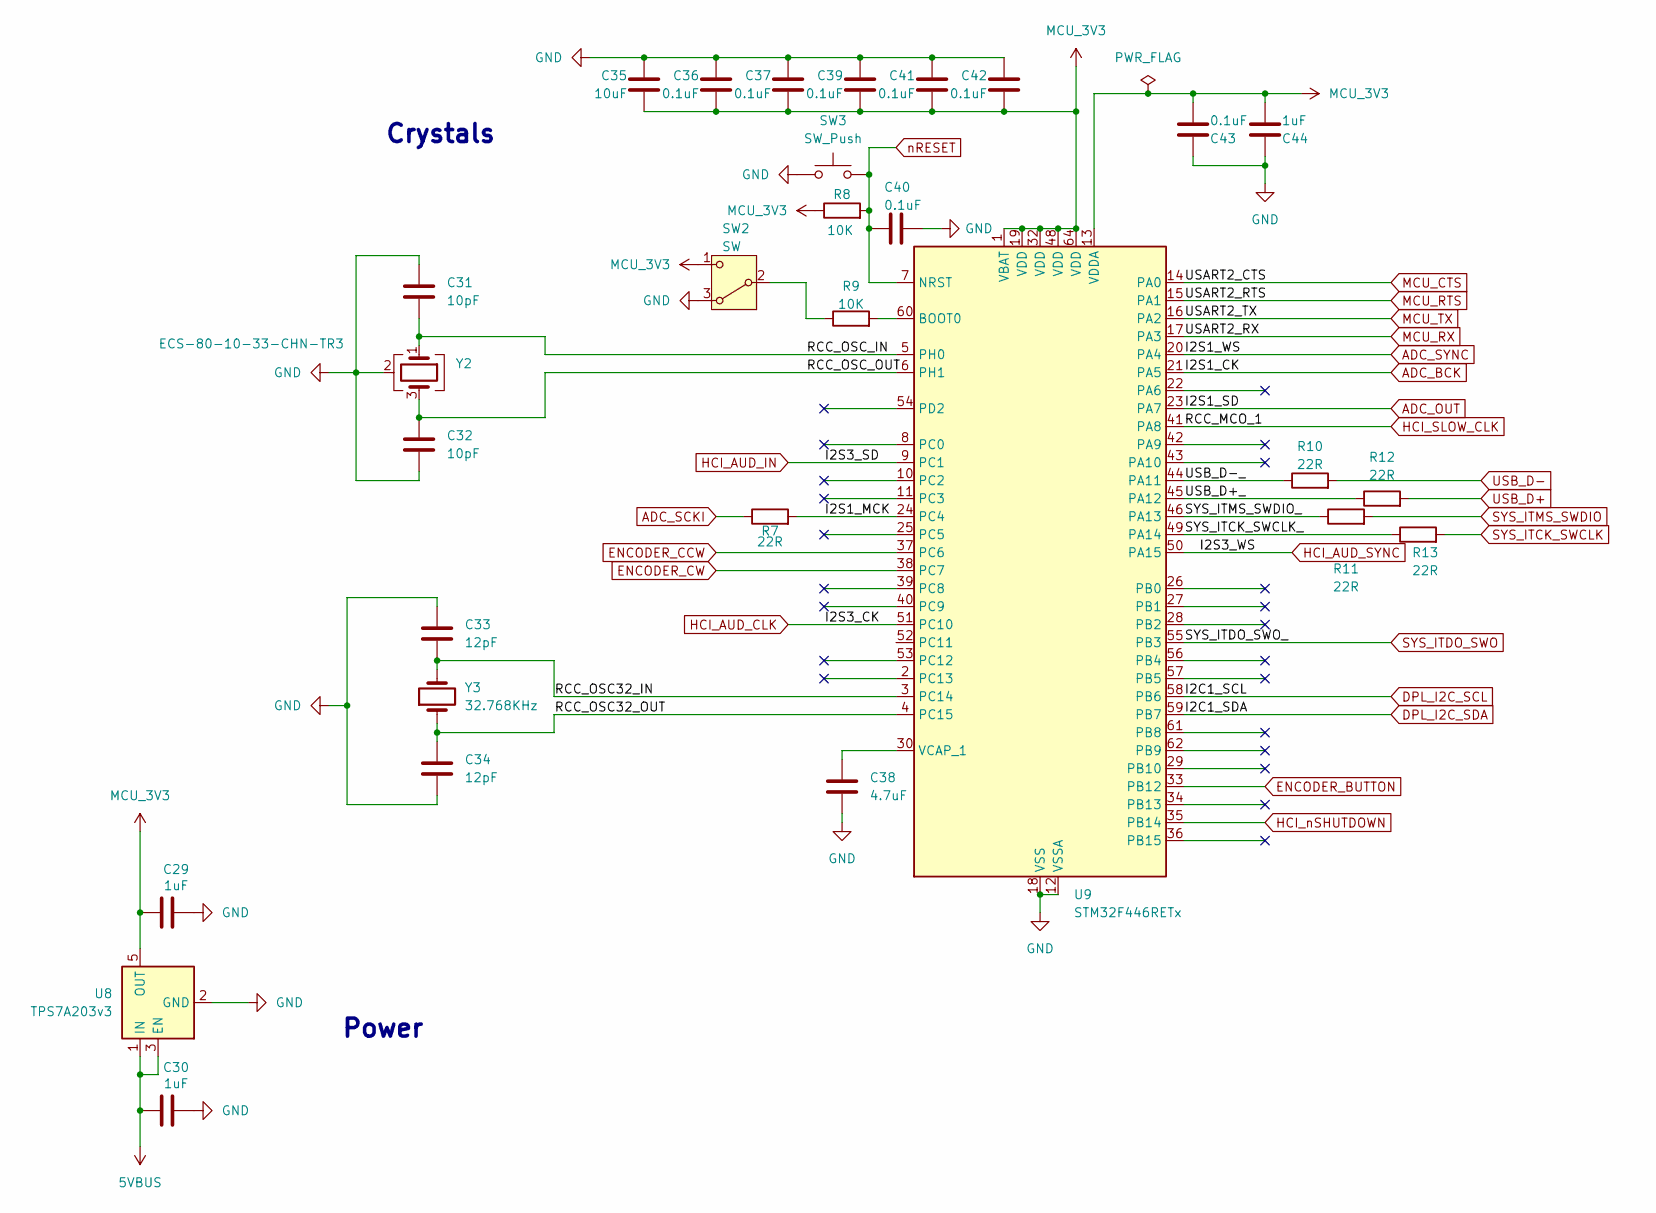
[picture p20: schematic MCU.kicad_sch, Microcontroller]

Parts:
C29, C30, C44: 1uF; C_0603_1608Metric_Pad1.08x0.95mm_HandSolder
C31, C32: 10pF; C_0402_1005Metric_Pad0.74x0.62mm_HandSolder
C33, C34: 12pF; C_0402_1005Metric_Pad0.74x0.62mm_HandSolder
C35: 10uF; C_0805_2012Metric_Pad1.18x1.45mm_HandSolder
C36, C37, C39, C40, C41, C42, C43: 0.1uF; C_0402_1005Metric_Pad0.74x0.62mm_HandSolder
C38: 4.7uF; C_0603_1608Metric_Pad1.08x0.95mm_HandSolder
R7, R10, R11, R12, R13: 22R; R_0603_1608Metric_Pad0.98x0.95mm_HandSolder
R8, R9: 10K; R_0603_1608Metric_Pad0.98x0.95mm_HandSolder
SW2: SW; SW_SPDT_PCM12
SW3: SW_Push; SW_PUSH_6mm_H5mm
U8: TPS7A203v3; SOT-23-5
U9: STM32F446RETx; LQFP-64_10x10mm_P0.5mm
Y2: ECS-80-10-33-CHN-TR3; ECS801033CHNTR3
Y3: 32.768KHz; ECS327734BTR

Connections:
5VBUS: C30.1, U8.1 (IN), U8.3 (EN); also elsewhere on the board
/MCU/I2S1_MCK: R7.2, U9.24 (PC4)
/MCU/RCC_OSC32_IN: C33.2, U9.3 (PC14), Y3.2
/MCU/RCC_OSC32_OUT: C34.1, U9.4 (PC15), Y3.1
/MCU/RCC_OSC_IN: C31.2, U9.5 (PH0), Y2.1
/MCU/RCC_OSC_OUT: C32.1, U9.6 (PH1), Y2.3
/MCU/SYS_ITCK_SWCLK_: R13.1, U9.49 (PA14)
/MCU/SYS_ITMS_SWDIO_: R11.1, U9.46 (PA13)
/MCU/USB_D+_: R12.1, U9.45 (PA12)
/MCU/USB_D-_: R10.1, U9.44 (PA11)
ADC_BCK: U9.21 (PA5); also elsewhere on the board
ADC_OUT: U9.23 (PA7); also elsewhere on the board
ADC_SCKI: R7.1; also elsewhere on the board
ADC_SYNC: U9.20 (PA4); also elsewhere on the board
DPL_I2C_SCL: U9.58 (PB6); also elsewhere on the board
DPL_I2C_SDA: U9.59 (PB7); also elsewhere on the board
ENCODER_BUTTON: U9.33 (PB12); also elsewhere on the board
ENCODER_CCW: U9.37 (PC6); also elsewhere on the board
ENCODER_CW: U9.38 (PC7); also elsewhere on the board
GND: C29.2, C30.2, C31.1, C32.2, C33.1, C34.2, C35.1, C36.1, C37.1, C38.2, C39.1, C40.1, C41.1, C42.1, C43.1, C44.1, SW2.3 (A), SW3.1, U8.2 (GND), U9.12 (VSSA), U9.18 (VSS), U9.31 (VSS), U9.47 (VSS), U9.63 (VSS), Y2.2 (G), Y2.4 (G); also elsewhere on the board
HCI_AUD_CLK: U9.51 (PC10); also elsewhere on the board
HCI_AUD_IN: U9.9 (PC1); also elsewhere on the board
HCI_AUD_SYNC: U9.50 (PA15); also elsewhere on the board
HCI_SLOW_CLK: U9.41 (PA8); also elsewhere on the board
HCI_nSHUTDOWN: U9.35 (PB14); also elsewhere on the board
MCU_3V3: C29.1, C35.2, C36.2, C37.2, C39.2, C41.2, C42.2, C43.2, C44.2, R8.1, SW2.1 (C), U8.5 (OUT), U9.1 (VBAT), U9.13 (VDDA), U9.19 (VDD), U9.32 (VDD), U9.48 (VDD), U9.64 (VDD); also elsewhere on the board
MCU_CTS: U9.14 (PA0); also elsewhere on the board
MCU_RTS: U9.15 (PA1); also elsewhere on the board
MCU_RX: U9.17 (PA3); also elsewhere on the board
MCU_TX: U9.16 (PA2); also elsewhere on the board
unnamed: R9.1, SW2.2 (B)
unnamed: R9.2, U9.60 (BOOT0)
unnamed: C38.1, U9.30 (VCAP_1)
SYS_ITCK_SWCLK: R13.2; also elsewhere on the board
SYS_ITDO_SWO: U9.55 (PB3); also elsewhere on the board
SYS_ITMS_SWDIO: R11.2; also elsewhere on the board
USB_D+: R12.2; also elsewhere on the board
USB_D-: R10.2; also elsewhere on the board
nRESET: C40.2, R8.2, SW3.2, U9.7 (NRST); also elsewhere on the board

Notes on the sheet:
Crystals
Power

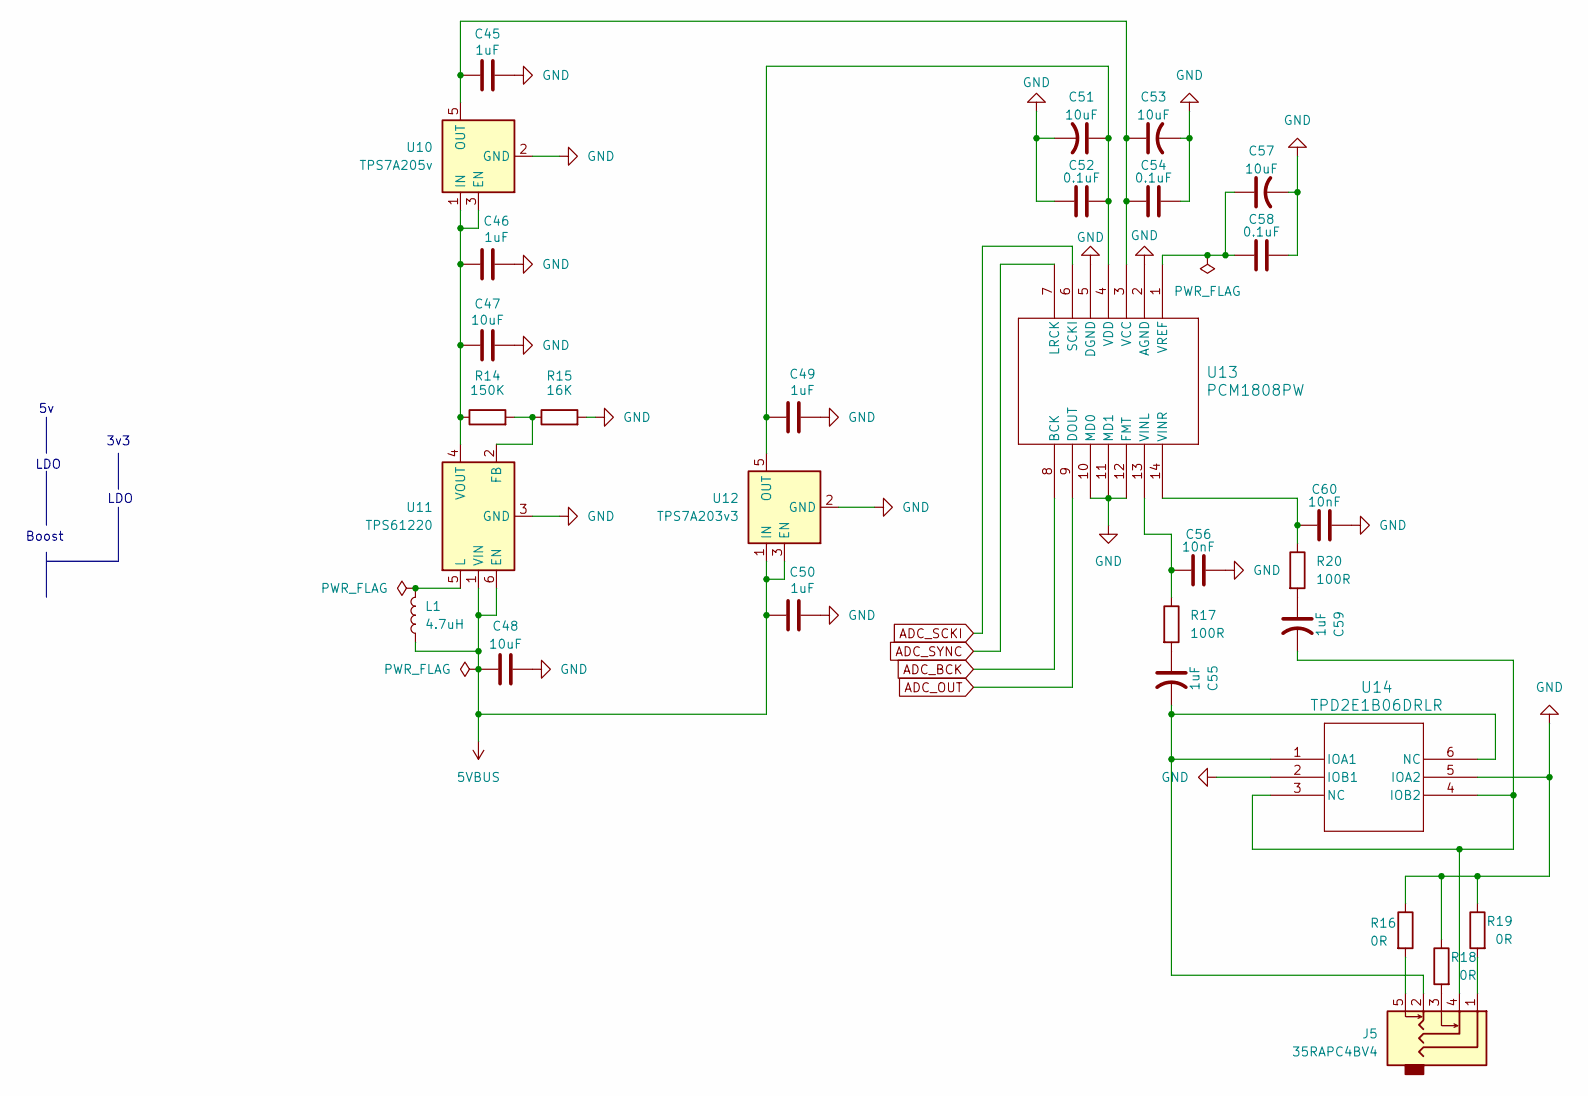
[picture p21: schematic Audio.kicad_sch]

Parts:
C45, C46, C49, C50: 1uF; C_0603_1608Metric_Pad1.08x0.95mm_HandSolder
C47, C48, C57: 10uF; C_0805_2012Metric_Pad1.18x1.45mm_HandSolder
C51, C53: 10uF; C_1206_3216Metric_Pad1.33x1.80mm_HandSolder
C52, C54, C58: 0.1uF; C_0402_1005Metric_Pad0.74x0.62mm_HandSolder
C55, C59: 1uF; C_Rect_L7.2mm_W5.5mm_P5.00mm_FKS2_FKP2_MKS2_MKP2
C56, C60: 10nF; C_0603_1608Metric_Pad1.08x0.95mm_HandSolder
J5: 35RAPC4BV4
L1: 4.7uH; L_Coilcraft_XFL2010
R14: 150K; R_0603_1608Metric_Pad0.98x0.95mm_HandSolder
R15: 16K; R_0603_1608Metric_Pad0.98x0.95mm_HandSolder
R16, R18, R19: 0R; C_0603_1608Metric_Pad1.08x0.95mm_HandSolder
R17, R20: 100R; R_0603_1608Metric_Pad0.98x0.95mm_HandSolder
U10: TPS7A205v; SOT-23-5
U11: TPS61220; Texas_R-PDSO-G6
U12: TPS7A203v3; SOT-23-5
U13: PCM1808PW; PW14-L
U14: TPD2E1B06DRLR; DRL6_TEX-L

Connections:
5VBUS: C48.1, C50.1, L1.1, U11.1 (VIN), U11.6 (EN), U12.1 (IN), U12.3 (EN); also elsewhere on the board
ADC_BCK: U13.8 (BCK); also elsewhere on the board
ADC_OUT: U13.9 (DOUT); also elsewhere on the board
ADC_SCKI: U13.6 (SCKI); also elsewhere on the board
ADC_SYNC: U13.7 (LRCK); also elsewhere on the board
GND: C45.2, C46.2, C47.2, C48.2, C49.2, C50.2, C51.2, C52.1, C53.2, C54.1, C56.1, C57.2, C58.1, C60.1, R15.2, R16.1, R18.1, R19.1, U10.2 (GND), U11.3 (GND), U12.2 (GND), U13.2 (AGND), U13.5 (DGND), U13.10 (MD0), U13.11 (MD1), U13.12 (FMT), U14.2 (IOB1), U14.5 (IOA2); also elsewhere on the board
unnamed: C55.1, R17.2
unnamed: C59.1, R20.2
unnamed: J5.1, R19.2
unnamed: J5.3, R18.2
unnamed: J5.5, R16.2
unnamed: C46.1, C47.1, R14.1, U10.1 (IN), U10.3 (EN), U11.4 (VOUT)
unnamed: C45.1, C53.1, C54.2, U10.5 (OUT), U13.3 (VCC)
unnamed: R14.2, R15.1, U11.2 (FB)
unnamed: L1.2, U11.5 (L)
unnamed: C49.1, C51.1, C52.2, U12.5 (OUT), U13.4 (VDD)
unnamed: C56.2, R17.1, U13.13 (VINL)
unnamed: C60.2, R20.1, U13.14 (VINR)
unnamed: C57.1, C58.2, U13.1 (VREF)
unnamed: C55.2, J5.2, U14.1 (IOA1), U14.6 (NC)
unnamed: C59.2, J5.4, U14.3 (NC), U14.4 (IOB2)

Notes on the sheet:
3v3
Boost
LDO

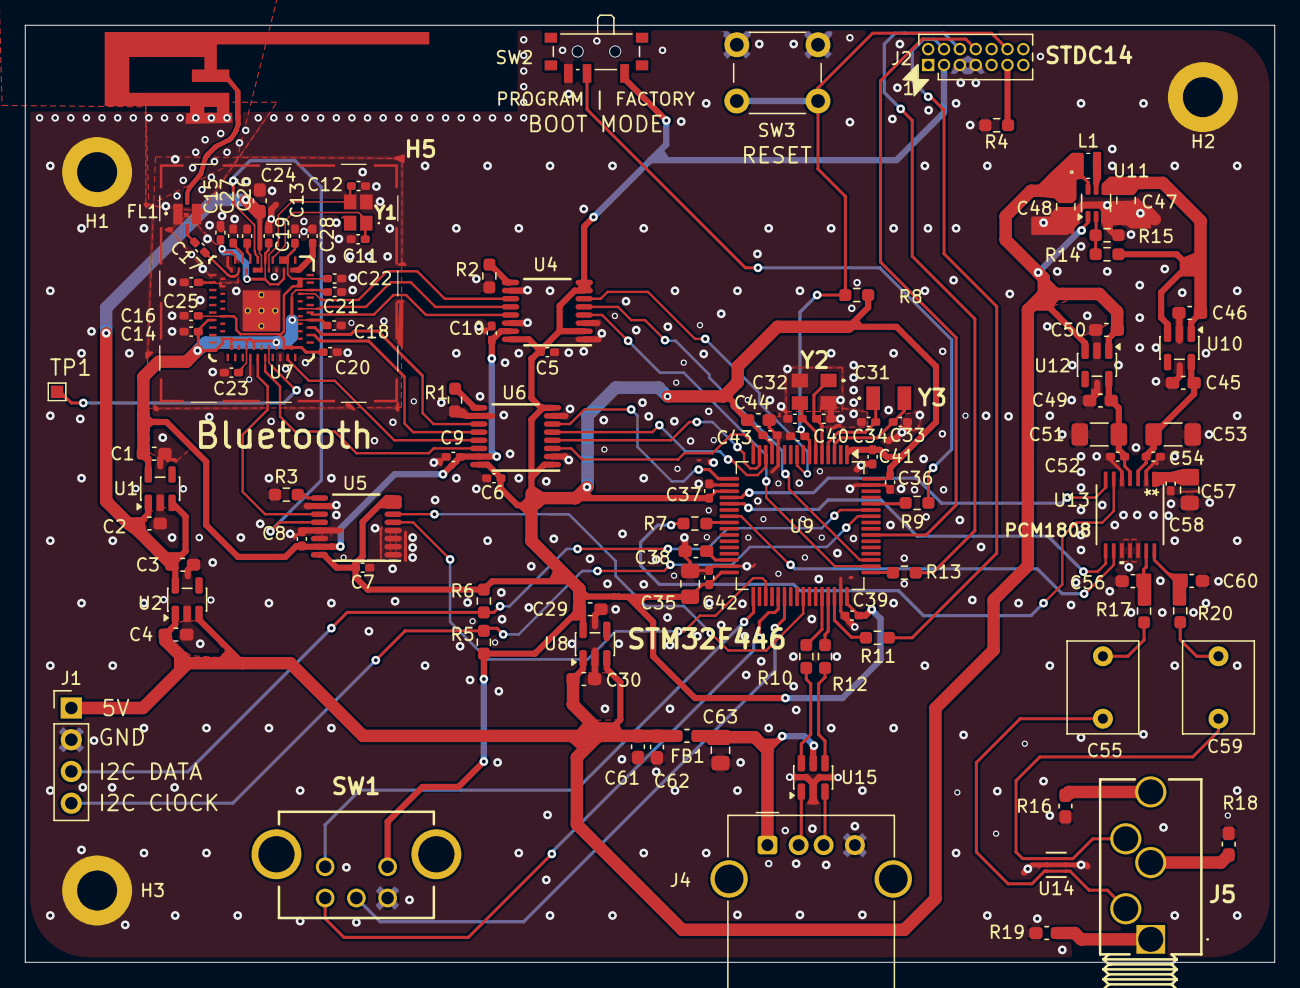
[picture p22: board Audio2BluetoothV1.kicad_pcb from above]

Board: 4 copper layers, 100.0 x 75.0 mm, 116 parts (0 on the bottom side), 83 nets.
