jcook-200/Piano2Bluetooth/(commit log)

2026-05-23 Update README.md
    Added to the ADC selection
2026-05-23 Add PDF schematic
    Schematic of the audio to Bluetooth PCB
2026-05-23 Added PCB pdf
2026-06-06 Add files via upload
    Gerber Zip added
2026-06-15 Create README
    added kicad folder
2026-06-15 Add files via upload
    added kicad design files
    [Audio.kicad_sch, Audio2BluetoothV1.csv, Audio2BluetoothV1.kicad_pcb, Audio2BluetoothV1.kicad_sch, Bluetooth.kicad_sch, InputOutput.kicad_sch, MCU.kicad_sch, Other.kicad_sch]
